gabeak2/KASM_ACTUATOR_PCB_REV2/README.md

A PCBA to drive voice coil actuators at Keck and University of Hawaii at Hilo.  Work done as part of my MS ECE Thesis at Johns Hopkins.  Please enjoy this beautiful glamor shot of my boards !
