gabeak2/KASM_ACTUATOR_PCB_REV2/kasm_pcb_rev2.step

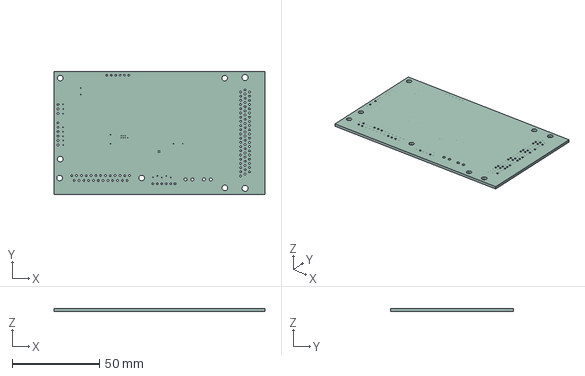
[picture p1: CAD file, 2024-11-26]
kasm_pcb_rev2.step
121.0 x 70.6 x 1.60 mm
