gabeak2/KASM_ACTUATOR_PCB_REV2/parts_libraries/LIB_09564527612/09564527612/3D/09564527612.stp

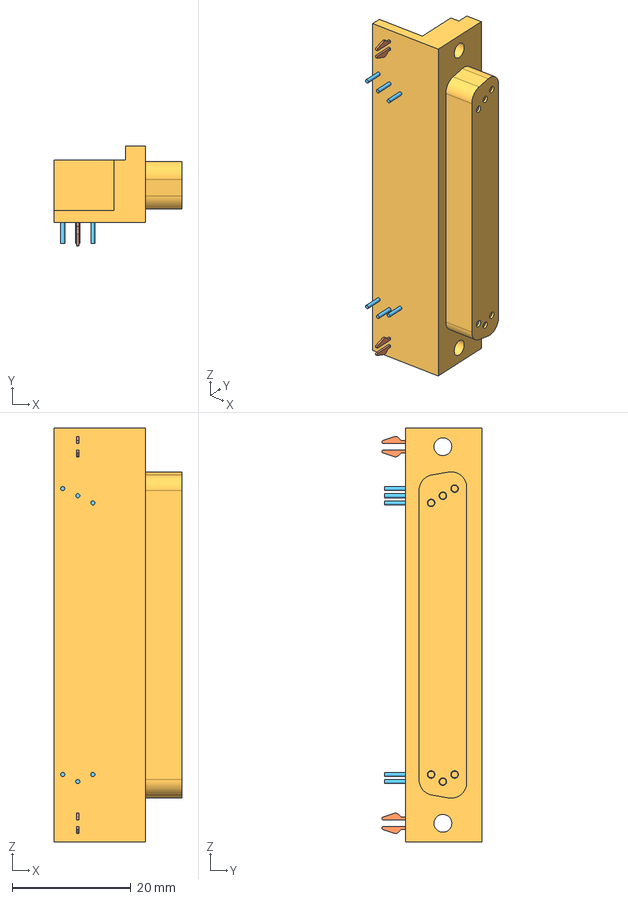
[picture p2: CAD file, 2024-10-26]
parts_libraries/LIB_09564527612/09564527612/3D/09564527612.stp
21.5 x 16.9 x 69.8 mm
