gabeak2/KASM_ACTUATOR_PCB_REV2/(list of files, cad)

Other CAD files:
parts_libraries/LIB_09564527612/09564527612/Allegro/09564527612.psm
parts_libraries/LIB_09564527612/09564527612/DEHDL/09564527612/chips/chips.prt
