gabeak2/KASM_ACTUATOR_PCB_REV2/(list of files, drawings)

Other design files:
parts_libraries/LIB_09564527612/09564527612/Altium/09564527612.PcbLib
parts_libraries/LIB_09564527612/09564527612/Altium/09564527612.SchLib
