gabeak2/KASM_ACTUATOR_PCB_REV2/kasm_pcb_rev2.kicad_pcb

## KiCad design kasm_pcb_rev2.kicad_pcb (2024-11-26)

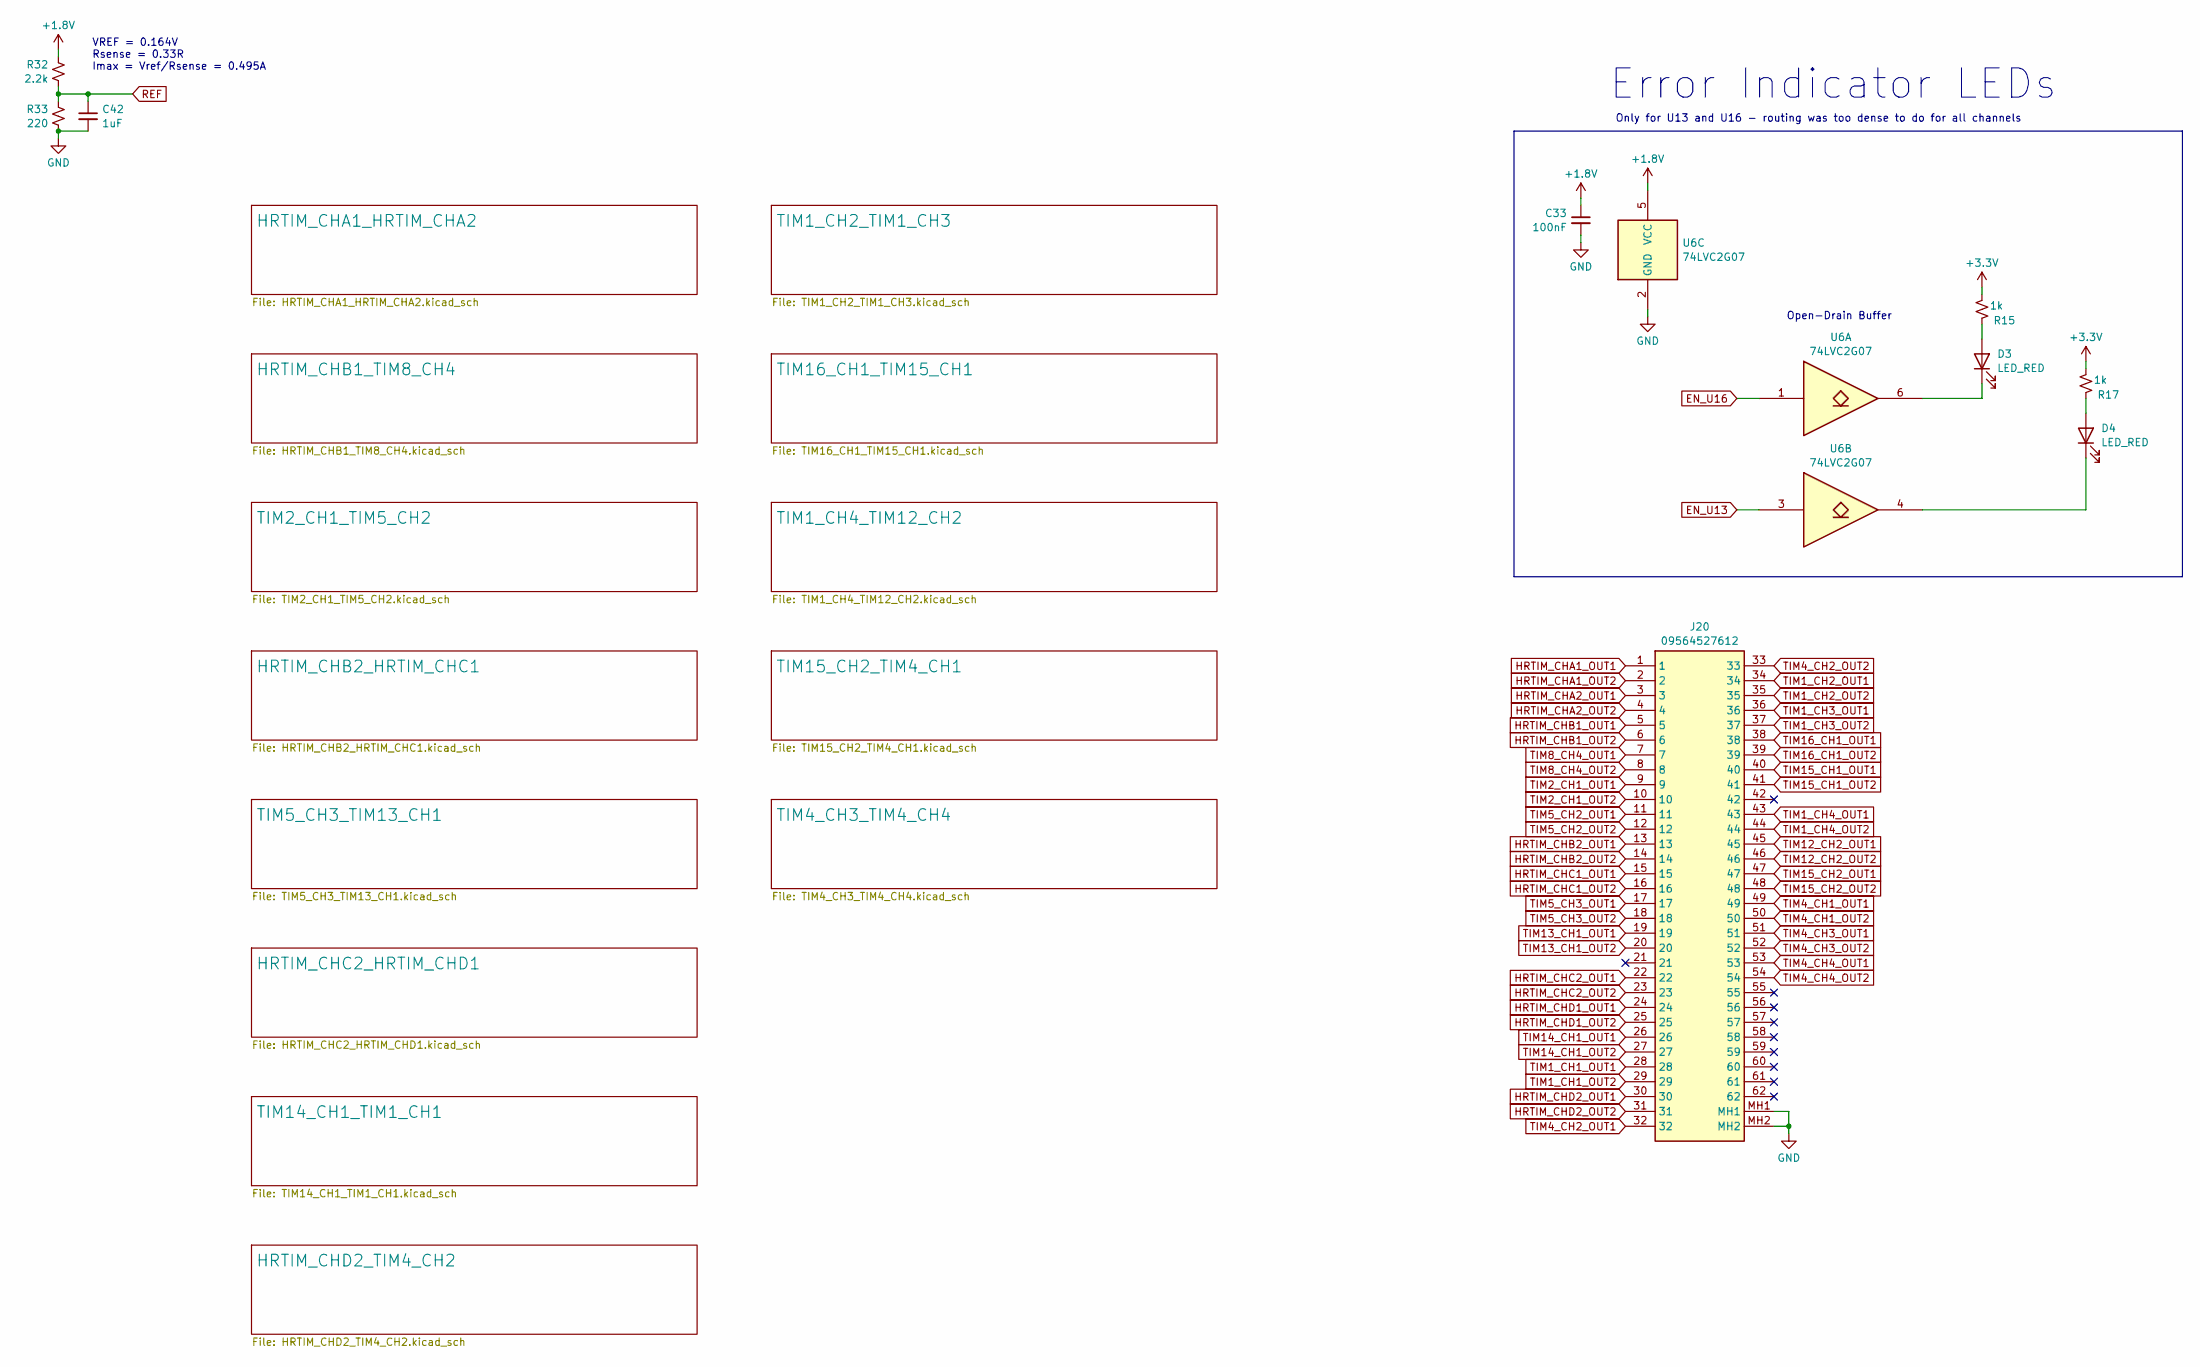
[picture p3: schematic actuators.kicad_sch, KASM Actuator PCBA Rev2]

Parts:
C33: 100nF; C_0402_1005Metric; LCSC C1525
C42: 1uF; C_0402_1005Metric; LCSC C52923
D3, D4: LED_RED; LED_0603_1608Metric; LCSC C2286
J20: 09564527612; Manufacturer_Part_Number 09564527612; Mouser Part Number 617-09-56-452-7612
R15, R17: 1k; R_0402_1005Metric; LCSC C11702
R32: 2.2k; R_0402_1005Metric; LCSC C25879
R33: 220; R_0402_1005Metric; LCSC C25091
U6: 74LVC2G07; SOT-23-6; LCSC C37708

Connections:
+1.8V: C33.1, R32.1, U6.5 (VCC); also elsewhere on the board
+3.3V: R15.1, R17.1; also elsewhere on the board
EN_U13: U6.3; also elsewhere on the board
EN_U16: U6.1; also elsewhere on the board
GND: C33.2, C42.2, J20.MH1, J20.MH2, R33.2, U6.2 (GND); also elsewhere on the board
HRTIM_CHA1_OUT1: J20.1; also elsewhere on the board
HRTIM_CHA1_OUT2: J20.2; also elsewhere on the board
HRTIM_CHA2_OUT1: J20.3; also elsewhere on the board
HRTIM_CHA2_OUT2: J20.4; also elsewhere on the board
HRTIM_CHB1_OUT1: J20.5; also elsewhere on the board
HRTIM_CHB1_OUT2: J20.6; also elsewhere on the board
HRTIM_CHB2_OUT1: J20.13; also elsewhere on the board
HRTIM_CHB2_OUT2: J20.14; also elsewhere on the board
HRTIM_CHC1_OUT1: J20.15; also elsewhere on the board
HRTIM_CHC1_OUT2: J20.16; also elsewhere on the board
HRTIM_CHC2_OUT1: J20.22; also elsewhere on the board
HRTIM_CHC2_OUT2: J20.23; also elsewhere on the board
HRTIM_CHD1_OUT1: J20.24; also elsewhere on the board
HRTIM_CHD1_OUT2: J20.25; also elsewhere on the board
HRTIM_CHD2_OUT1: J20.30; also elsewhere on the board
HRTIM_CHD2_OUT2: J20.31; also elsewhere on the board
unnamed: D3.2 (A), R15.2
unnamed: D3.1 (K), U6.6
unnamed: D4.2 (A), R17.2
unnamed: D4.1 (K), U6.4
REF: C42.1, R32.2, R33.1; also elsewhere on the board
TIM1_CH1_OUT1: J20.28; also elsewhere on the board
TIM1_CH1_OUT2: J20.29; also elsewhere on the board
TIM1_CH2_OUT1: J20.34; also elsewhere on the board
TIM1_CH2_OUT2: J20.35; also elsewhere on the board
TIM1_CH3_OUT1: J20.36; also elsewhere on the board
TIM1_CH3_OUT2: J20.37; also elsewhere on the board
TIM1_CH4_OUT1: J20.43; also elsewhere on the board
TIM1_CH4_OUT2: J20.44; also elsewhere on the board
TIM2_CH1_OUT1: J20.9; also elsewhere on the board
TIM2_CH1_OUT2: J20.10; also elsewhere on the board
TIM4_CH1_OUT1: J20.49; also elsewhere on the board
TIM4_CH1_OUT2: J20.50; also elsewhere on the board
TIM4_CH2_OUT1: J20.32; also elsewhere on the board
TIM4_CH2_OUT2: J20.33; also elsewhere on the board
TIM4_CH3_OUT1: J20.51; also elsewhere on the board
TIM4_CH3_OUT2: J20.52; also elsewhere on the board
TIM4_CH4_OUT1: J20.53; also elsewhere on the board
TIM4_CH4_OUT2: J20.54; also elsewhere on the board
TIM5_CH2_OUT1: J20.11; also elsewhere on the board
TIM5_CH2_OUT2: J20.12; also elsewhere on the board
TIM5_CH3_OUT1: J20.17; also elsewhere on the board
TIM5_CH3_OUT2: J20.18; also elsewhere on the board
TIM8_CH4_OUT1: J20.7; also elsewhere on the board
TIM8_CH4_OUT2: J20.8; also elsewhere on the board
TIM12_CH2_OUT1: J20.45; also elsewhere on the board
TIM12_CH2_OUT2: J20.46; also elsewhere on the board
TIM13_CH1_OUT1: J20.19; also elsewhere on the board
TIM13_CH1_OUT2: J20.20; also elsewhere on the board
TIM14_CH1_OUT1: J20.26; also elsewhere on the board
TIM14_CH1_OUT2: J20.27; also elsewhere on the board
TIM15_CH1_OUT1: J20.40; also elsewhere on the board
TIM15_CH1_OUT2: J20.41; also elsewhere on the board
TIM15_CH2_OUT1: J20.47; also elsewhere on the board
TIM15_CH2_OUT2: J20.48; also elsewhere on the board
TIM16_CH1_OUT1: J20.38; also elsewhere on the board
TIM16_CH1_OUT2: J20.39; also elsewhere on the board

Notes on the sheet:
Only for U13 and U16 - routing was too dense to do for all channels
Error Indicator LEDs
Open-Drain Buffer
VREF = 0.164V Rsense = 0.33R Imax = Vref/Rsense = 0.495A

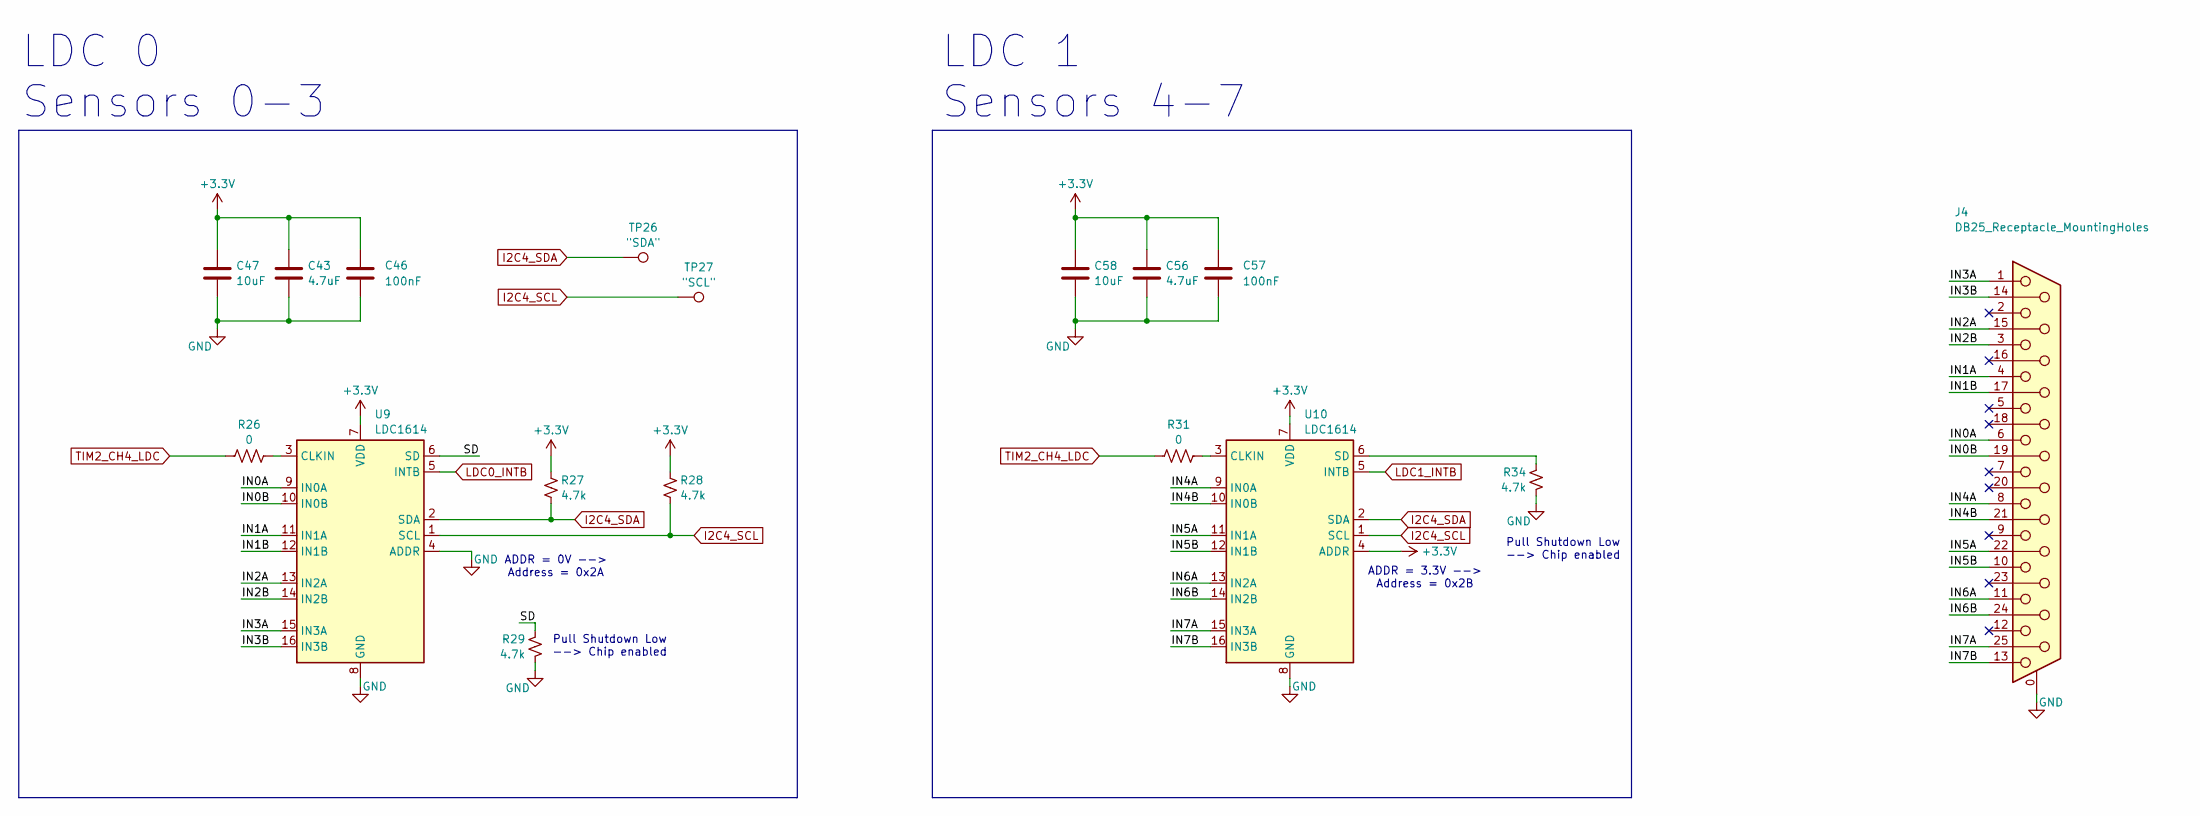
[picture p4: schematic eddy_current_sensors.kicad_sch, KASM Actuator PCBA Rev2]

Parts:
C43, C56: 4.7uF; C_0402_1005Metric; LCSC C23733
C46, C57: 100nF; C_0402_1005Metric; LCSC C307331
C47, C58: 10uF; C_0805_2012Metric; LCSC C440198
J4: DB25_Receptacle_MountingHoles; TE_5747846-4
R26, R31: 0; R_0402_1005Metric; LCSC C17168
R27, R28, R29, R34: 4.7k; R_0402_1005Metric; LCSC C25900
TP26: "SDA"; TestPoint_THTPad_D1.0mm_Drill0.5mm
TP27: "SCL"; TestPoint_THTPad_D1.0mm_Drill0.5mm
U9, U10: LDC1614; WQFN-16-1EP_4x4mm_P0.5mm_EP2.6x2.6mm; LCSC C968448

Connections:
+3.3V: C43.1, C46.1, C47.1, C56.1, C57.1, C58.1, R27.1, R28.1, U9.7 (VDD), U10.4 (ADDR), U10.7 (VDD); also elsewhere on the board
/Eddy Current Sensors/IN0A: J4.6, U9.9 (IN0A)
/Eddy Current Sensors/IN0B: J4.19, U9.10 (IN0B)
/Eddy Current Sensors/IN1A: J4.4, U9.11 (IN1A)
/Eddy Current Sensors/IN1B: J4.17, U9.12 (IN1B)
/Eddy Current Sensors/IN2A: J4.15, U9.13 (IN2A)
/Eddy Current Sensors/IN2B: J4.3, U9.14 (IN2B)
/Eddy Current Sensors/IN3A: J4.1, U9.15 (IN3A)
/Eddy Current Sensors/IN3B: J4.14, U9.16 (IN3B)
/Eddy Current Sensors/IN4A: J4.8, U10.9 (IN0A)
/Eddy Current Sensors/IN4B: J4.21, U10.10 (IN0B)
/Eddy Current Sensors/IN5A: J4.22, U10.11 (IN1A)
/Eddy Current Sensors/IN5B: J4.10, U10.12 (IN1B)
/Eddy Current Sensors/IN6A: J4.11, U10.13 (IN2A)
/Eddy Current Sensors/IN6B: J4.24, U10.14 (IN2B)
/Eddy Current Sensors/IN7A: J4.25, U10.15 (IN3A)
/Eddy Current Sensors/IN7B: J4.13, U10.16 (IN3B)
/Eddy Current Sensors/SD: R29.1, U9.6 (SD)
GND: C43.2, C46.2, C47.2, C56.2, C57.2, C58.2, J4.0 (PAD), R29.2, R34.2, U9.4 (ADDR), U9.8 (GND), U9.17 (GND), U10.8 (GND), U10.17 (GND); also elsewhere on the board
I2C4_SCL: R28.2, TP27.1, U9.1 (SCL), U10.1 (SCL); also elsewhere on the board
I2C4_SDA: R27.2, TP26.1, U9.2 (SDA), U10.2 (SDA); also elsewhere on the board
LDC0_INTB: U9.5 (INTB); also elsewhere on the board
LDC1_INTB: U10.5 (INTB); also elsewhere on the board
unnamed: R26.1, U9.3 (CLKIN)
unnamed: R31.1, U10.3 (CLKIN)
unnamed: R34.1, U10.6 (SD)
TIM2_CH4_LDC: R26.2, R31.2; also elsewhere on the board

Notes on the sheet:
Pull Shutdown Low --> Chip enabled
LDC 0 Sensors 0-3
LDC 1 Sensors 4-7
ADDR = 3.3V --> Address = 0x2B
ADDR = 0V --> Address = 0x2A

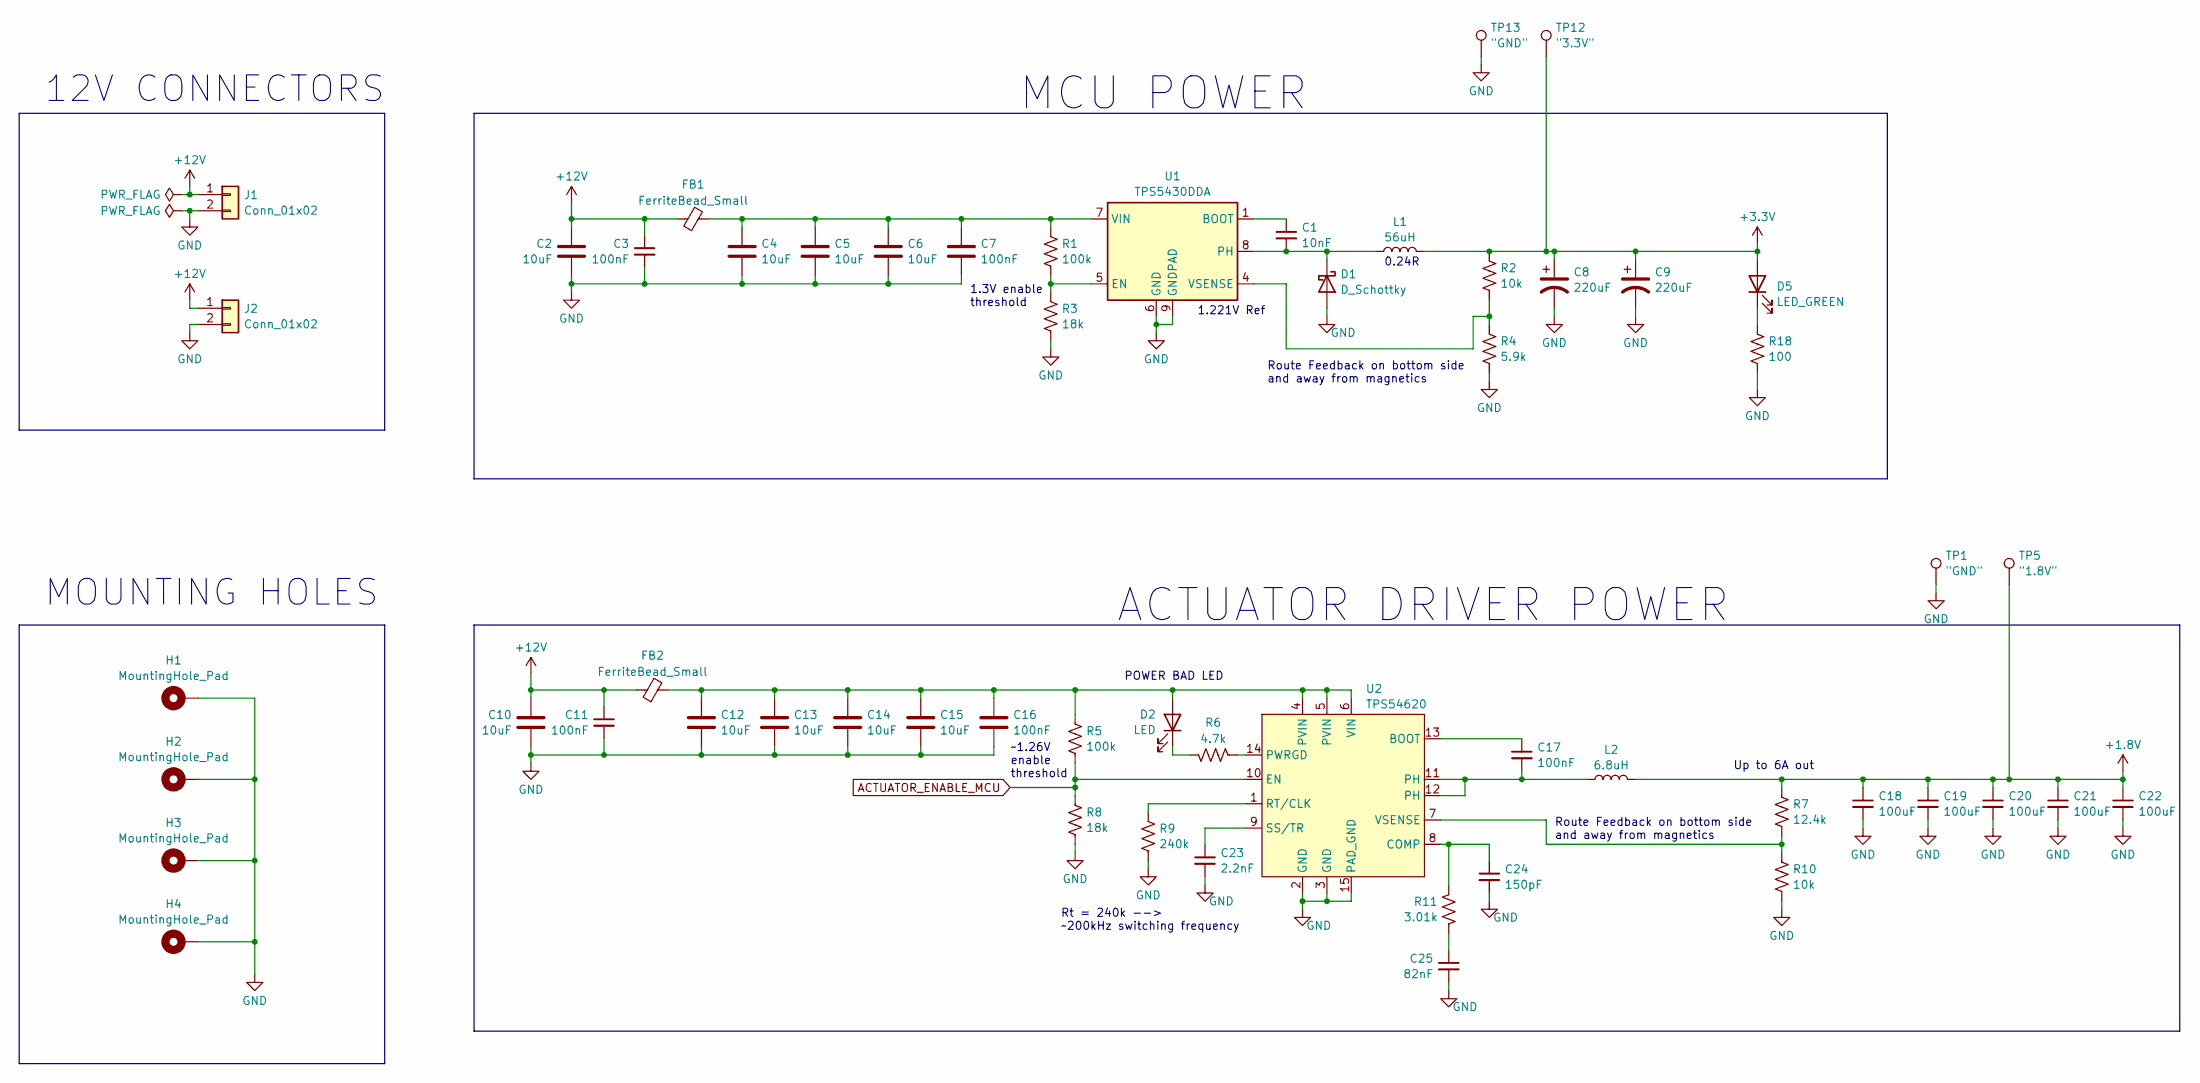
[picture p5: schematic power.kicad_sch, KASM Actuator PCBA Rev2]

Parts:
C1: 10nF; C_0402_1005Metric; LCSC C60133
C2, C4, C5, C6, C10, C12, C13, C14, C15: 10uF; C_1206_3216Metric; LCSC C454102
C3, C7, C11, C16, C17: 100nF; C_0402_1005Metric; LCSC C1525
C8, C9: 220uF; CP_Elec_6.3x5.4; LCSC C59953
C18, C19, C20, C21, C22: 100uF; C_1206_3216Metric; LCSC C15008
C23: 2.2nF; C_0402_1005Metric; LCSC C1531
C24: 150pF; C_0402_1005Metric; LCSC C106998
C25: 82nF; C_0402_1005Metric; LCSC C524617
D1: D_Schottky; D_SOD-323; LCSC C191023
D2: LED; LED_0603_1608Metric; LCSC C2286
D5: LED_GREEN; LED_0603_1608Metric; LCSC C965804
FB1, FB2: FerriteBead_Small; L_0805_2012Metric; LCSC C1017
H1, H2, H3, H4: MountingHole_Pad; MountingHole_3.2mm_M3_DIN965_Pad
J1, J2: Conn_01x02; Molex_KK-396_A-41792-0002_1x02_P3.96mm_Horizontal
L1: 56uH; L_Changjiang_FNR5020S; LCSC C167944
L2: 6.8uH; L_Chilisin_BMRF00101040; LCSC C167231
R1, R5: 100k; R_0402_1005Metric; LCSC C25741
R2, R10: 10k; R_0402_1005Metric; LCSC C25744
R3, R8: 18k; R_0402_1005Metric; LCSC C138044
R4: 5.9k; R_0402_1005Metric; LCSC C270591
R6: 4.7k; R_0402_1005Metric; LCSC C25900
R7: 12.4k; R_0402_1005Metric; LCSC C11692
R9: 240k; R_0402_1005Metric; LCSC C138030
R11: 3.01k; R_0402_1005Metric; LCSC C137994
R18: 100; R_0402_1005Metric; LCSC C106232
TP1, TP13: "GND"; TestPoint_THTPad_1.0x1.0mm_Drill0.5mm
TP5: "1.8V"; TestPoint_THTPad_1.0x1.0mm_Drill0.5mm
TP12: "3.3V"; TestPoint_THTPad_1.0x1.0mm_Drill0.5mm
U1: TPS5430DDA; TI_SO-PowerPAD-8_ThermalVias; LCSC C9864
U2: TPS54620; Texas_S-PVQFN-N14_ThermalVias; LCSC C29438

Connections:
+1.8V: C18.1, C19.1, C20.1, C21.1, C22.1, L2.2, R7.1, TP5.1; also elsewhere on the board
+3.3V: C8.1, C9.1, D5.2 (A), L1.2, R2.1, TP12.1; also elsewhere on the board
+12V: C2.1, C3.1, C10.1, C11.1, FB1.1, FB2.1, J1.1, J2.1
ACTUATOR_ENABLE_MCU: R5.2, R8.1, U2.10 (EN); also elsewhere on the board
GND: C2.2, C3.2, C4.2, C5.2, C6.2, C7.2, C8.2, C9.2, C10.2, C11.2, C12.2, C13.2, C14.2, C15.2, C16.2, C18.2, C19.2, C20.2, C21.2, C22.2, C23.2, C24.2, C25.2, D1.2 (A), H1.1, H2.1, H3.1, H4.1, J1.2, J2.2, R3.2, R4.2, R8.2, R9.2, R10.2, R18.2, TP1.1, TP13.1, U1.6 (GND), U1.9 (GNDPAD), U2.2 (GND), U2.3 (GND), U2.15 (PAD_GND); also elsewhere on the board
unnamed: C17.2, L2.1, U2.11 (PH), U2.12 (PH)
unnamed: C25.1, R11.2
unnamed: C1.2, D1.1 (K), L1.1, U1.8 (PH)
unnamed: C12.1, C13.1, C14.1, C15.1, C16.1, D2.2 (A), FB2.2, R5.1, U2.4 (PVIN), U2.5 (PVIN), U2.6 (VIN)
unnamed: D2.1 (K), R6.2
unnamed: D5.1 (K), R18.1
unnamed: C1.1, U1.1 (BOOT)
unnamed: R1.2, R3.1, U1.5 (EN)
unnamed: C4.1, C5.1, C6.1, C7.1, FB1.2, R1.1, U1.7 (VIN)
unnamed: R2.2, R4.1, U1.4 (VSENSE)
unnamed: C17.1, U2.13 (BOOT)
unnamed: C24.1, R11.1, U2.8 (COMP)
unnamed: R6.1, U2.14 (PWRGD)
unnamed: R9.1, U2.1 (RT/CLK)
unnamed: C23.1, U2.9 (SS/TR)
unnamed: R7.2, R10.1, U2.7 (VSENSE)

Notes on the sheet:
Up to 6A out
1.221V Ref
Rt = 240k --> ~200kHz switching frequency
1.3V enable threshold
Route Feedback on bottom side and away from magnetics
ACTUATOR DRIVER POWER
~1.26V enable threshold
0.24R
POWER BAD LED
12V CONNECTORS
MCU POWER
MOUNTING HOLES

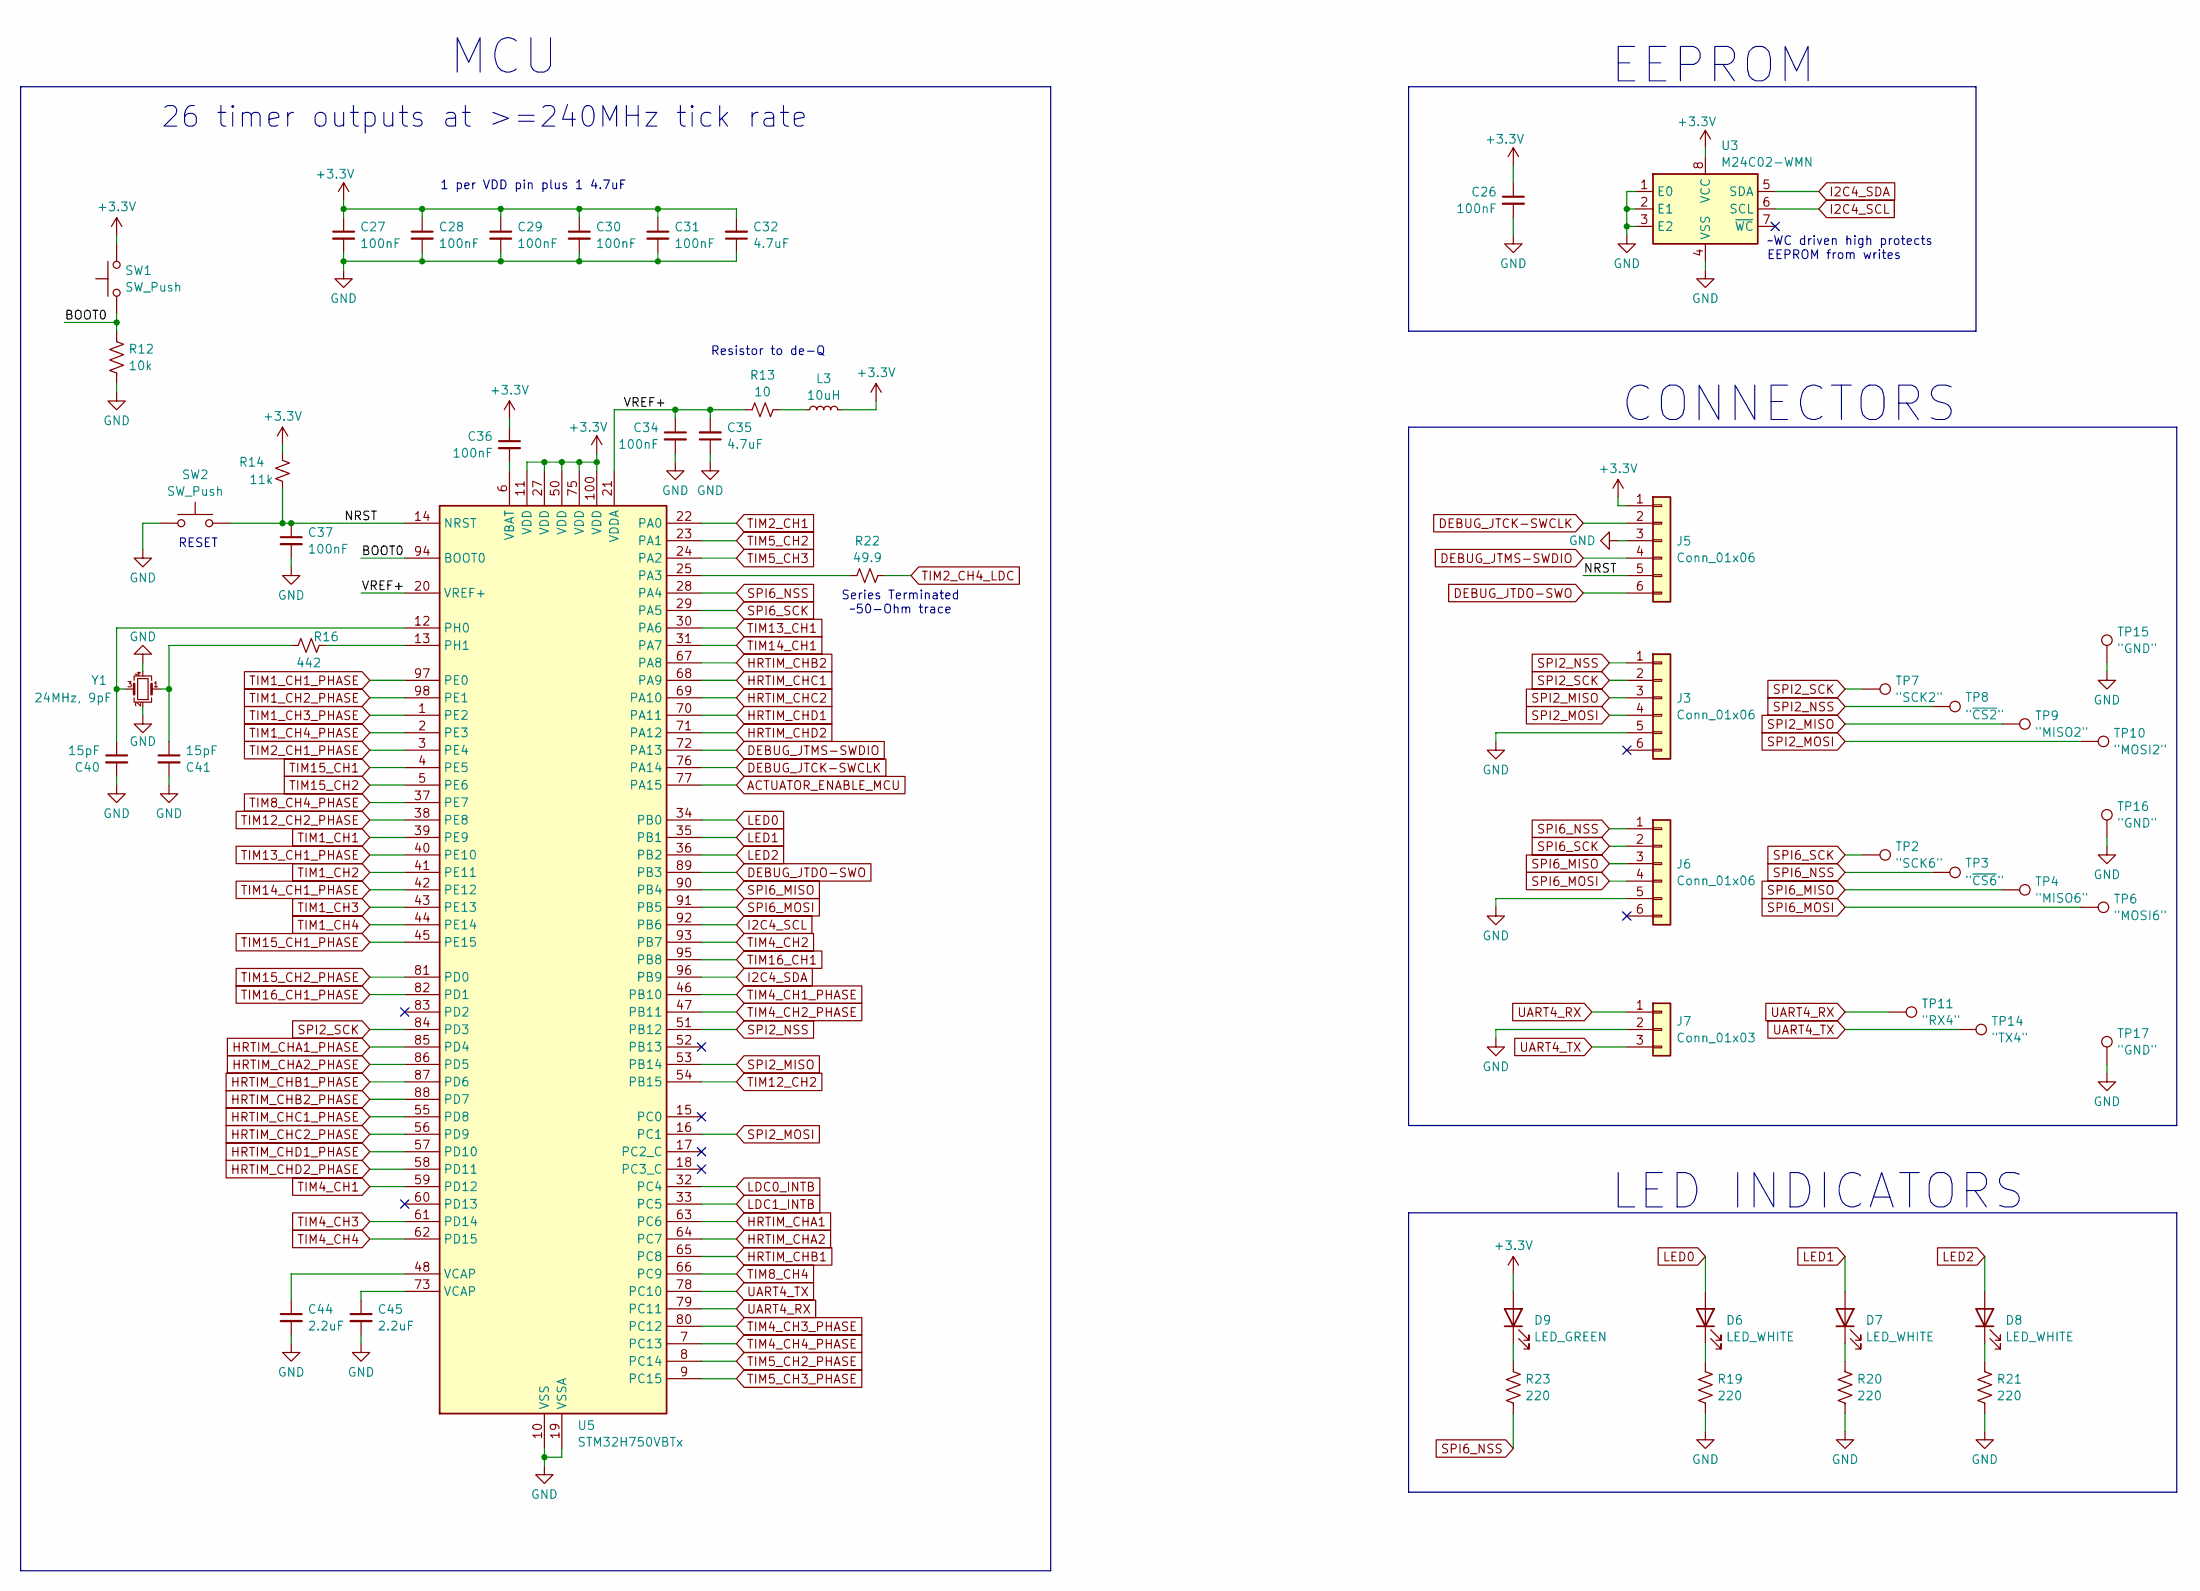
[picture p6: schematic mcu.kicad_sch, KASM Actuator PCBA Rev2]

Parts:
C26, C27, C28, C29, C30, C31, C34, C36, C37: 100nF; C_0402_1005Metric; LCSC C1525
C32, C35: 4.7uF; C_0402_1005Metric; LCSC C23733
C40, C41: 15pF; C_0402_1005Metric; LCSC C1548
C44, C45: 2.2uF; C_0402_1005Metric; LCSC C12530
D6, D7, D8: LED_WHITE; LED_0402_1005Metric; LCSC C20613596
D9: LED_GREEN; LED_0603_1608Metric; LCSC C965804
J3, J5: Conn_01x06; PinHeader_1x06_P2.54mm_Vertical
J6: Conn_01x06; CONN_A-7478-06A_MOL
J7: Conn_01x03; PinHeader_1x03_P2.54mm_Vertical
L3: 10uH; L_0603_1608Metric; LCSC C51942
R12: 10k; R_0402_1005Metric; LCSC C25744
R13: 10; R_0402_1005Metric; LCSC C409845
R14: 11k; R_0402_1005Metric; LCSC C25749
R16: 442; R_0402_1005Metric; LCSC C126137
R19, R20, R21, R23: 220; R_0402_1005Metric; LCSC C25091
R22: 49.9; R_0402_1005Metric; LCSC C144754
SW1, SW2: SW_Push; SW_Push_1P1T_XKB_TS-1187A; LCSC C318884
TP2: "SCK6"; TestPoint_THTPad_1.0x1.0mm_Drill0.5mm
TP3: "~{CS6}"; TestPoint_THTPad_1.0x1.0mm_Drill0.5mm
TP4: "MISO6"; TestPoint_THTPad_1.0x1.0mm_Drill0.5mm
TP6: "MOSI6"; TestPoint_THTPad_1.0x1.0mm_Drill0.5mm
TP7: "SCK2"; TestPoint_THTPad_1.0x1.0mm_Drill0.5mm
TP8: "~{CS2}"; TestPoint_THTPad_1.0x1.0mm_Drill0.5mm
TP9: "MISO2"; TestPoint_THTPad_1.0x1.0mm_Drill0.5mm
TP10: "MOSI2"; TestPoint_THTPad_1.0x1.0mm_Drill0.5mm
TP11: "RX4"; TestPoint_THTPad_1.0x1.0mm_Drill0.5mm
TP14: "TX4"; TestPoint_THTPad_1.0x1.0mm_Drill0.5mm
TP15, TP16, TP17: "GND"; TestPoint_THTPad_1.0x1.0mm_Drill0.5mm
U3: M24C02-WMN; SOIC-8_3.9x4.9mm_P1.27mm; LCSC C7562
U5: STM32H750VBTx; LQFP-100_14x14mm_P0.5mm; LCSC C404010
Y1: 24MHz, 9pF; Crystal_SMD_SeikoEpson_FA128-4Pin_2.0x1.6mm; LCSC C2929399

Connections:
+3.3V: C26.1, C27.1, C28.1, C29.1, C30.1, C31.1, C32.2, C36.1, D9.2 (A), J5.1, L3.2, R14.1, SW1.2, U3.8 (VCC), U5.11 (VDD), U5.27 (VDD), U5.50 (VDD), U5.75 (VDD), U5.100 (VDD); also elsewhere on the board
/MCU/BOOT0: R12.1, SW1.1, U5.94 (BOOT0)
/MCU/NRST: C37.1, J5.5, R14.2, SW2.2, U5.14 (NRST)
/MCU/VREF+: C34.1, C35.2, R13.1, U5.20 (VREF+), U5.21 (VDDA)
ACTUATOR_ENABLE_MCU: U5.77 (PA15); also elsewhere on the board
DEBUG_JTCK-SWCLK: J5.2, U5.76 (PA14)
DEBUG_JTDO-SWO: J5.6, U5.89 (PB3)
DEBUG_JTMS-SWDIO: J5.4, U5.72 (PA13)
GND: C26.2, C27.2, C28.2, C29.2, C30.2, C31.2, C32.1, C34.2, C35.1, C37.2, C40.2, C41.2, C44.2, C45.2, J3.5, J5.3, J6.5, J7.2, R12.2, R19.2, R20.2, R21.2, SW2.1, TP15.1, TP16.1, TP17.1, U3.1 (E0), U3.2 (E1), U3.3 (E2), U3.4 (VSS), U5.10 (VSS), U5.19 (VSSA), U5.26 (VSS), U5.49 (VSS), U5.74 (VSS), U5.99 (VSS), Y1.2, Y1.4; also elsewhere on the board
HRTIM_CHA1: U5.63 (PC6); also elsewhere on the board
HRTIM_CHA1_PHASE: U5.85 (PD4); also elsewhere on the board
HRTIM_CHA2: U5.64 (PC7); also elsewhere on the board
HRTIM_CHA2_PHASE: U5.86 (PD5); also elsewhere on the board
HRTIM_CHB1: U5.65 (PC8); also elsewhere on the board
HRTIM_CHB1_PHASE: U5.87 (PD6); also elsewhere on the board
HRTIM_CHB2: U5.67 (PA8); also elsewhere on the board
HRTIM_CHB2_PHASE: U5.88 (PD7); also elsewhere on the board
HRTIM_CHC1: U5.68 (PA9); also elsewhere on the board
HRTIM_CHC1_PHASE: U5.55 (PD8); also elsewhere on the board
HRTIM_CHC2: U5.69 (PA10); also elsewhere on the board
HRTIM_CHC2_PHASE: U5.56 (PD9); also elsewhere on the board
HRTIM_CHD1: U5.70 (PA11); also elsewhere on the board
HRTIM_CHD1_PHASE: U5.57 (PD10); also elsewhere on the board
HRTIM_CHD2: U5.71 (PA12); also elsewhere on the board
HRTIM_CHD2_PHASE: U5.58 (PD11); also elsewhere on the board
I2C4_SCL: U3.6 (SCL), U5.92 (PB6); also elsewhere on the board
I2C4_SDA: U3.5 (SDA), U5.96 (PB9); also elsewhere on the board
LDC0_INTB: U5.32 (PC4); also elsewhere on the board
LDC1_INTB: U5.33 (PC5); also elsewhere on the board
LED0: D6.2 (A), U5.34 (PB0)
LED1: D7.2 (A), U5.35 (PB1)
LED2: D8.2 (A), U5.36 (PB2)
unnamed: C41.1, R16.1, Y1.1
unnamed: C44.1, U5.48 (VCAP)
unnamed: C45.1, U5.73 (VCAP)
unnamed: D6.1 (K), R19.1
unnamed: D7.1 (K), R20.1
unnamed: D8.1 (K), R21.1
unnamed: D9.1 (K), R23.1
unnamed: L3.1, R13.2
unnamed: R22.1, U5.25 (PA3)
unnamed: C40.1, U5.12 (PH0), Y1.3
unnamed: R16.2, U5.13 (PH1)
unnamed: C36.2, U5.6 (VBAT)
SPI2_MISO: J3.3, TP9.1, U5.53 (PB14)
SPI2_MOSI: J3.4, TP10.1, U5.16 (PC1)
SPI2_NSS: J3.1, TP8.1, U5.51 (PB12)
SPI2_SCK: J3.2, TP7.1, U5.84 (PD3)
SPI6_MISO: J6.3, TP4.1, U5.90 (PB4)
SPI6_MOSI: J6.4, TP6.1, U5.91 (PB5)
SPI6_NSS: J6.1, R23.2, TP3.1, U5.28 (PA4)
SPI6_SCK: J6.2, TP2.1, U5.29 (PA5)
TIM1_CH1: U5.39 (PE9); also elsewhere on the board
TIM1_CH1_PHASE: U5.97 (PE0); also elsewhere on the board
TIM1_CH2: U5.41 (PE11); also elsewhere on the board
TIM1_CH2_PHASE: U5.98 (PE1); also elsewhere on the board
TIM1_CH3: U5.43 (PE13); also elsewhere on the board
TIM1_CH3_PHASE: U5.1 (PE2); also elsewhere on the board
TIM1_CH4: U5.44 (PE14); also elsewhere on the board
TIM1_CH4_PHASE: U5.2 (PE3); also elsewhere on the board
TIM2_CH1: U5.22 (PA0); also elsewhere on the board
TIM2_CH1_PHASE: U5.3 (PE4); also elsewhere on the board
TIM2_CH4_LDC: R22.2; also elsewhere on the board
TIM4_CH1: U5.59 (PD12); also elsewhere on the board
TIM4_CH1_PHASE: U5.46 (PB10); also elsewhere on the board
TIM4_CH2: U5.93 (PB7); also elsewhere on the board
TIM4_CH2_PHASE: U5.47 (PB11); also elsewhere on the board
TIM4_CH3: U5.61 (PD14); also elsewhere on the board
TIM4_CH3_PHASE: U5.80 (PC12); also elsewhere on the board
TIM4_CH4: U5.62 (PD15); also elsewhere on the board
TIM4_CH4_PHASE: U5.7 (PC13); also elsewhere on the board
TIM5_CH2: U5.23 (PA1); also elsewhere on the board
TIM5_CH2_PHASE: U5.8 (PC14); also elsewhere on the board
TIM5_CH3: U5.24 (PA2); also elsewhere on the board
TIM5_CH3_PHASE: U5.9 (PC15); also elsewhere on the board
TIM8_CH4: U5.66 (PC9); also elsewhere on the board
TIM8_CH4_PHASE: U5.37 (PE7); also elsewhere on the board
TIM12_CH2: U5.54 (PB15); also elsewhere on the board
TIM12_CH2_PHASE: U5.38 (PE8); also elsewhere on the board
TIM13_CH1: U5.30 (PA6); also elsewhere on the board
TIM13_CH1_PHASE: U5.40 (PE10); also elsewhere on the board
TIM14_CH1: U5.31 (PA7); also elsewhere on the board
TIM14_CH1_PHASE: U5.42 (PE12); also elsewhere on the board
TIM15_CH1: U5.4 (PE5); also elsewhere on the board
TIM15_CH1_PHASE: U5.45 (PE15); also elsewhere on the board
TIM15_CH2: U5.5 (PE6); also elsewhere on the board
TIM15_CH2_PHASE: U5.81 (PD0); also elsewhere on the board
TIM16_CH1: U5.95 (PB8); also elsewhere on the board
TIM16_CH1_PHASE: U5.82 (PD1); also elsewhere on the board
UART4_RX: J7.1, TP11.1, U5.79 (PC11)
UART4_TX: J7.3, TP14.1, U5.78 (PC10)

Notes on the sheet:
~WC driven high protects EEPROM from writes
CONNECTORS
RESET
26 timer outputs at >=240MHz tick rate
Series Terminated ~50-Ohm trace
Resistor to de-Q
MCU
LED INDICATORS
EEPROM
1 per VDD pin plus 1 4.7uF

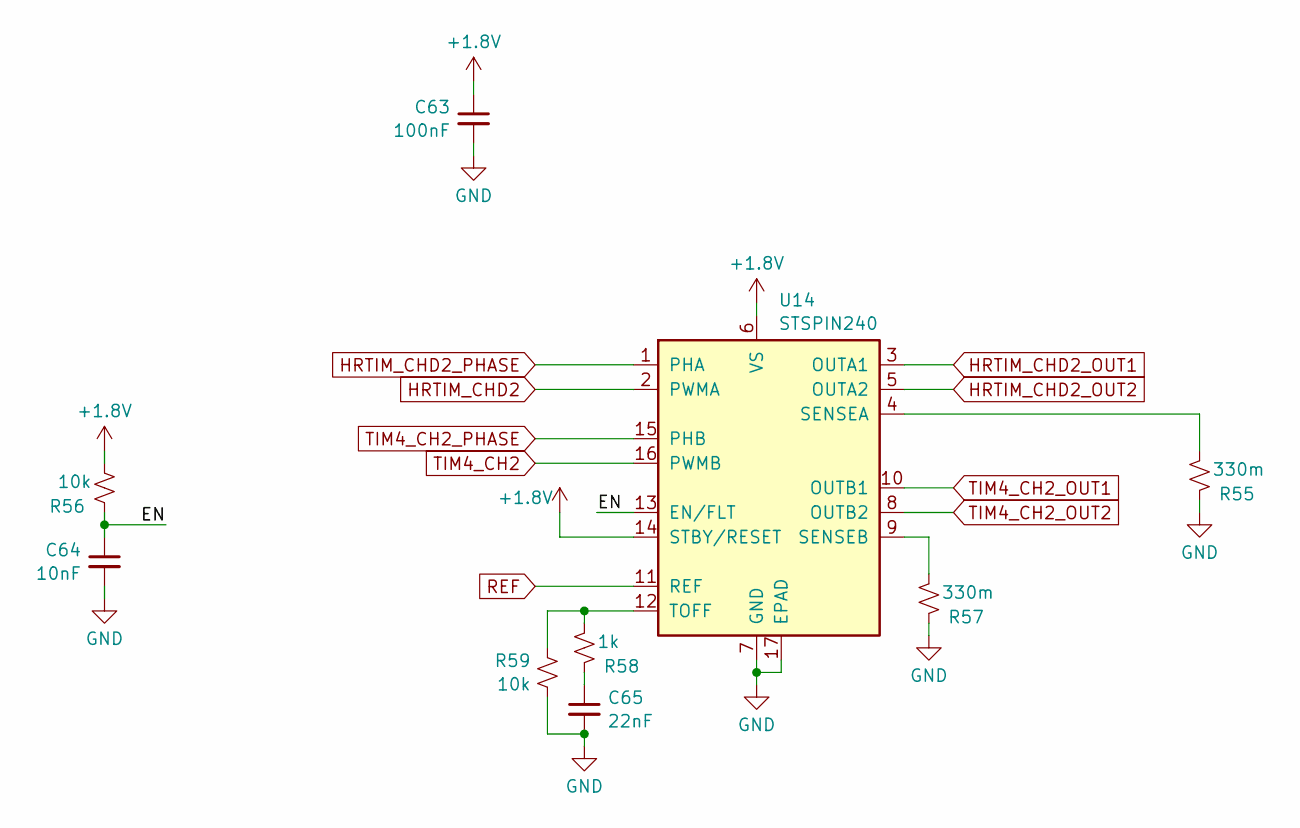
[picture p7: schematic HRTIM_CHD2_TIM4_CH2.kicad_sch]

Parts:
C63: 100nF; C_0402_1005Metric; LCSC C1525
C64: 10nF; C_0402_1005Metric; LCSC C15195
C65: 22nF; C_0402_1005Metric; LCSC C1532
R55, R57: 330m; R_0402_1005Metric; LCSC C332660
R56, R59: 10k; R_0402_1005Metric; LCSC C25744
R58: 1k; R_0402_1005Metric; LCSC C11702
U14: STSPIN240; VQFN-16-1EP_3x3mm_P0.5mm_EP1.8x1.8mm; LCSC C962258

Connections:
+1.8V: C63.1, R56.1, U14.6 (VS), U14.14 (STBY/RESET); also elsewhere on the board
/Actuators/HRTIM_CHD2_TIM4_CH2/EN: C64.1, R56.2, U14.13 (EN/FLT)
GND: C63.2, C64.2, C65.2, R55.2, R57.2, R59.2, U14.7 (GND), U14.17 (EPAD); also elsewhere on the board
HRTIM_CHD2: U14.2 (PWMA); also elsewhere on the board
HRTIM_CHD2_OUT1: U14.3 (OUTA1); also elsewhere on the board
HRTIM_CHD2_OUT2: U14.5 (OUTA2); also elsewhere on the board
HRTIM_CHD2_PHASE: U14.1 (PHA); also elsewhere on the board
unnamed: C65.1, R58.2
unnamed: R55.1, U14.4 (SENSEA)
unnamed: R57.1, U14.9 (SENSEB)
unnamed: R58.1, R59.1, U14.12 (TOFF)
REF: U14.11 (REF); also elsewhere on the board
TIM4_CH2: U14.16 (PWMB); also elsewhere on the board
TIM4_CH2_OUT1: U14.10 (OUTB1); also elsewhere on the board
TIM4_CH2_OUT2: U14.8 (OUTB2); also elsewhere on the board
TIM4_CH2_PHASE: U14.15 (PHB); also elsewhere on the board
