gabeak2/KASM_ACTUATOR_PCB_REV2/kasm_pcb_rev2.kicad_pcb

## KiCad design kasm_pcb_rev2.kicad_pcb (continued)

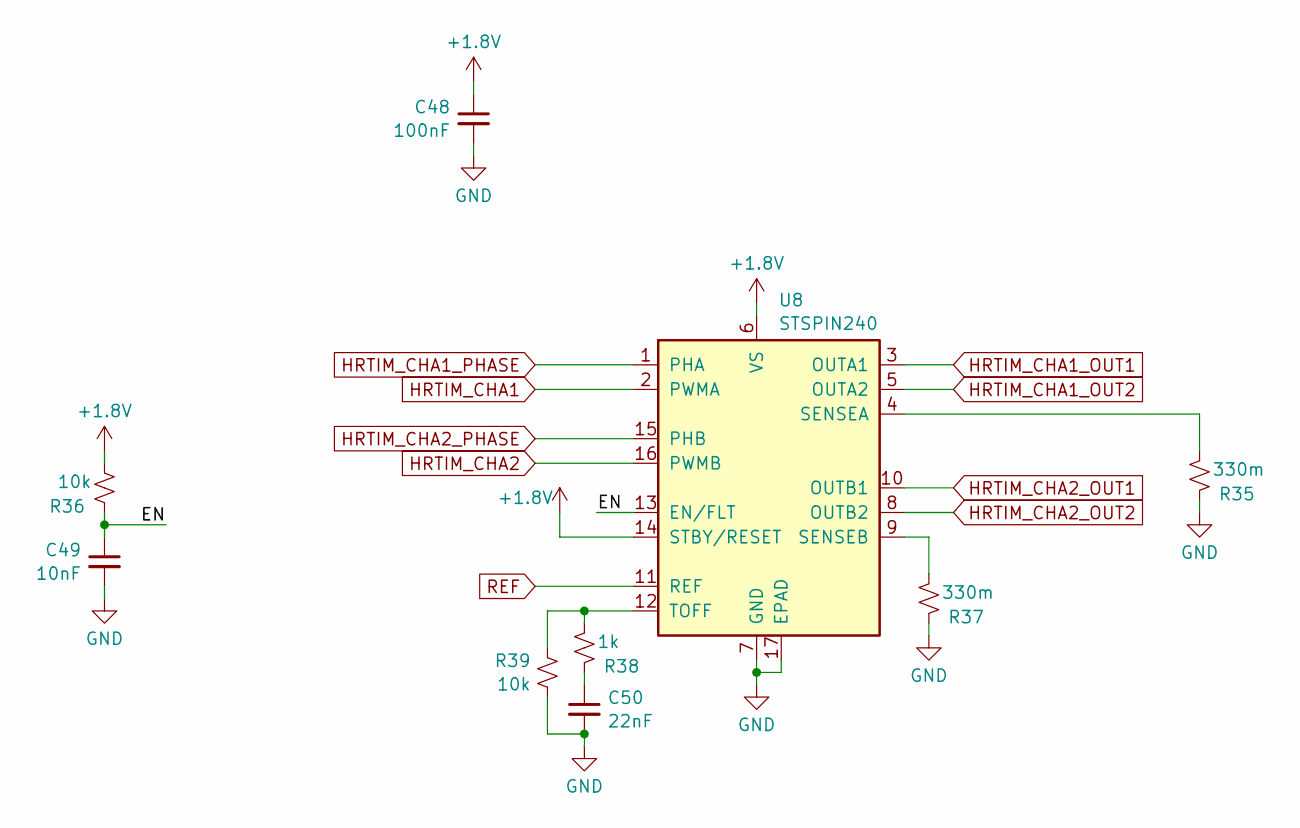
[picture p8: schematic HRTIM_CHA1_HRTIM_CHA2.kicad_sch]

Parts:
C48: 100nF; C_0402_1005Metric; LCSC C1525
C49: 10nF; C_0402_1005Metric; LCSC C15195
C50: 22nF; C_0402_1005Metric; LCSC C1532
R35, R37: 330m; R_0402_1005Metric; LCSC C332660
R36, R39: 10k; R_0402_1005Metric; LCSC C25744
R38: 1k; R_0402_1005Metric; LCSC C11702
U8: STSPIN240; VQFN-16-1EP_3x3mm_P0.5mm_EP1.8x1.8mm; LCSC C962258

Connections:
+1.8V: C48.1, R36.1, U8.6 (VS), U8.14 (STBY/RESET); also elsewhere on the board
/Actuators/HRTIM_CHA1_HRTIM_CHA2/EN: C49.1, R36.2, U8.13 (EN/FLT)
GND: C48.2, C49.2, C50.2, R35.2, R37.2, R39.2, U8.7 (GND), U8.17 (EPAD); also elsewhere on the board
HRTIM_CHA1: U8.2 (PWMA); also elsewhere on the board
HRTIM_CHA1_OUT1: U8.3 (OUTA1); also elsewhere on the board
HRTIM_CHA1_OUT2: U8.5 (OUTA2); also elsewhere on the board
HRTIM_CHA1_PHASE: U8.1 (PHA); also elsewhere on the board
HRTIM_CHA2: U8.16 (PWMB); also elsewhere on the board
HRTIM_CHA2_OUT1: U8.10 (OUTB1); also elsewhere on the board
HRTIM_CHA2_OUT2: U8.8 (OUTB2); also elsewhere on the board
HRTIM_CHA2_PHASE: U8.15 (PHB); also elsewhere on the board
unnamed: C50.1, R38.2
unnamed: R35.1, U8.4 (SENSEA)
unnamed: R37.1, U8.9 (SENSEB)
unnamed: R38.1, R39.1, U8.12 (TOFF)
REF: U8.11 (REF); also elsewhere on the board

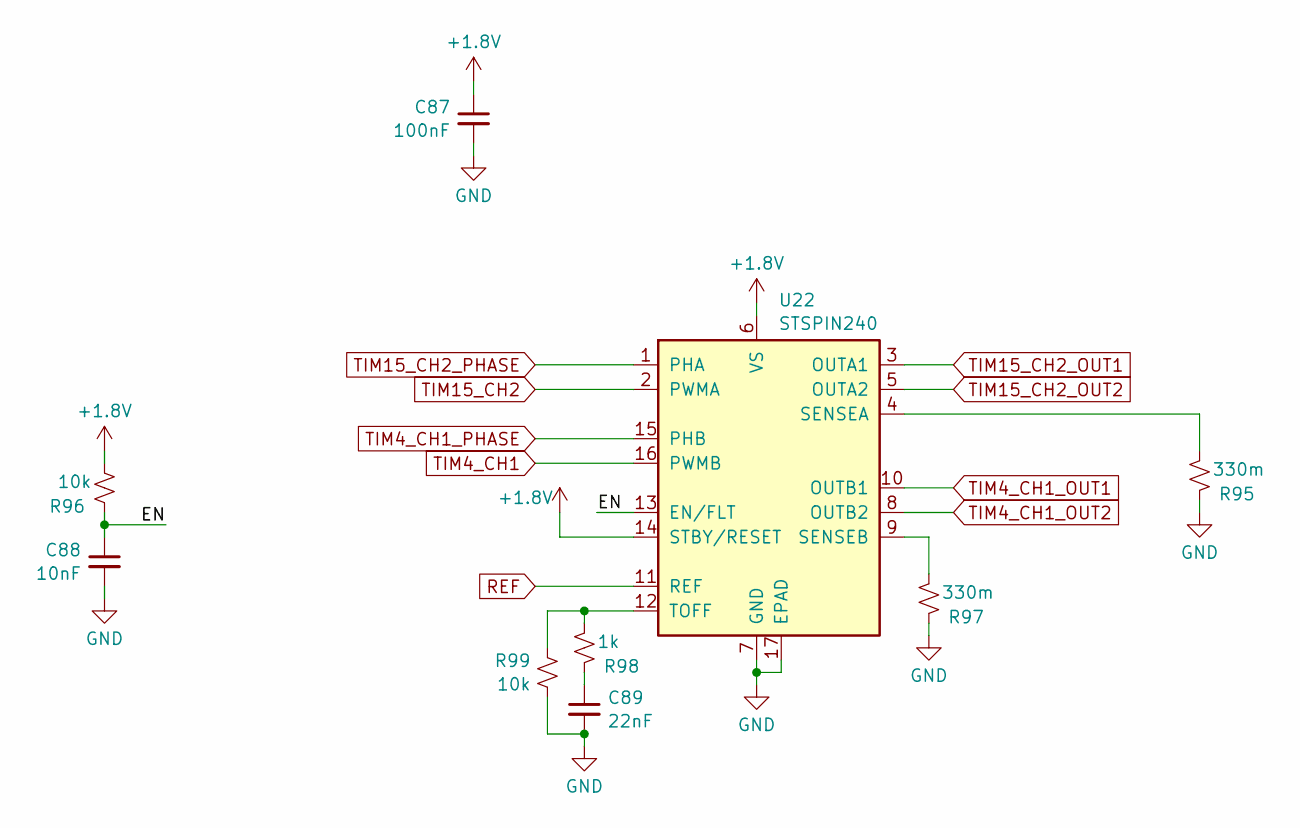
[picture p9: schematic TIM15_CH2_TIM4_CH1.kicad_sch]

Parts:
C87: 100nF; C_0402_1005Metric; LCSC C1525
C88: 10nF; C_0402_1005Metric; LCSC C15195
C89: 22nF; C_0402_1005Metric; LCSC C1532
R95, R97: 330m; R_0402_1005Metric; LCSC C332660
R96, R99: 10k; R_0402_1005Metric; LCSC C25744
R98: 1k; R_0402_1005Metric; LCSC C11702
U22: STSPIN240; VQFN-16-1EP_3x3mm_P0.5mm_EP1.8x1.8mm; LCSC C962258

Connections:
+1.8V: C87.1, R96.1, U22.6 (VS), U22.14 (STBY/RESET); also elsewhere on the board
/Actuators/TIM15_CH2_TIM4_CH1/EN: C88.1, R96.2, U22.13 (EN/FLT)
GND: C87.2, C88.2, C89.2, R95.2, R97.2, R99.2, U22.7 (GND), U22.17 (EPAD); also elsewhere on the board
unnamed: C89.1, R98.2
unnamed: R95.1, U22.4 (SENSEA)
unnamed: R97.1, U22.9 (SENSEB)
unnamed: R98.1, R99.1, U22.12 (TOFF)
REF: U22.11 (REF); also elsewhere on the board
TIM4_CH1: U22.16 (PWMB); also elsewhere on the board
TIM4_CH1_OUT1: U22.10 (OUTB1); also elsewhere on the board
TIM4_CH1_OUT2: U22.8 (OUTB2); also elsewhere on the board
TIM4_CH1_PHASE: U22.15 (PHB); also elsewhere on the board
TIM15_CH2: U22.2 (PWMA); also elsewhere on the board
TIM15_CH2_OUT1: U22.3 (OUTA1); also elsewhere on the board
TIM15_CH2_OUT2: U22.5 (OUTA2); also elsewhere on the board
TIM15_CH2_PHASE: U22.1 (PHA); also elsewhere on the board

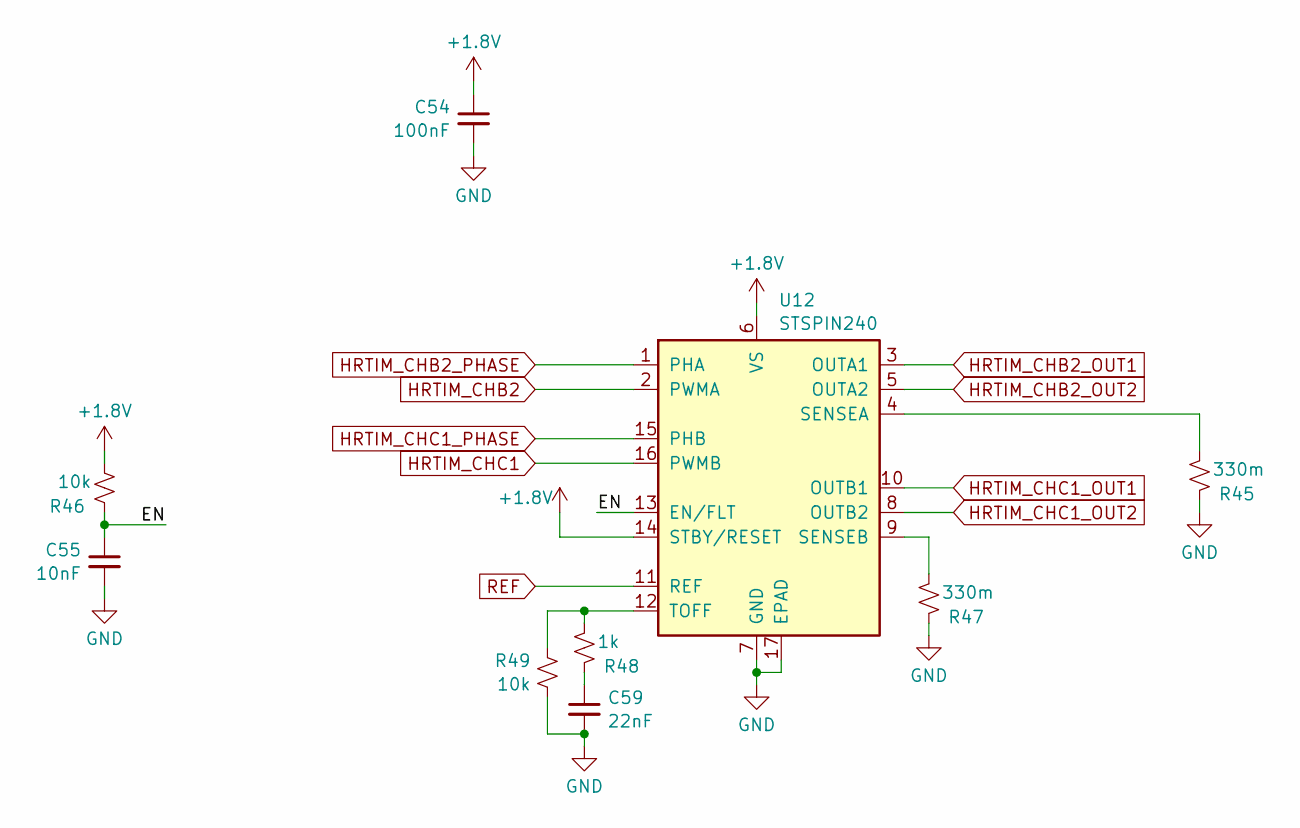
[picture p10: schematic HRTIM_CHB2_HRTIM_CHC1.kicad_sch]

Parts:
C54: 100nF; C_0402_1005Metric; LCSC C1525
C55: 10nF; C_0402_1005Metric; LCSC C15195
C59: 22nF; C_0402_1005Metric; LCSC C1532
R45, R47: 330m; R_0402_1005Metric; LCSC C332660
R46, R49: 10k; R_0402_1005Metric; LCSC C25744
R48: 1k; R_0402_1005Metric; LCSC C11702
U12: STSPIN240; VQFN-16-1EP_3x3mm_P0.5mm_EP1.8x1.8mm; LCSC C962258

Connections:
+1.8V: C54.1, R46.1, U12.6 (VS), U12.14 (STBY/RESET); also elsewhere on the board
/Actuators/HRTIM_CHB2_HRTIM_CHC1/EN: C55.1, R46.2, U12.13 (EN/FLT)
GND: C54.2, C55.2, C59.2, R45.2, R47.2, R49.2, U12.7 (GND), U12.17 (EPAD); also elsewhere on the board
HRTIM_CHB2: U12.2 (PWMA); also elsewhere on the board
HRTIM_CHB2_OUT1: U12.3 (OUTA1); also elsewhere on the board
HRTIM_CHB2_OUT2: U12.5 (OUTA2); also elsewhere on the board
HRTIM_CHB2_PHASE: U12.1 (PHA); also elsewhere on the board
HRTIM_CHC1: U12.16 (PWMB); also elsewhere on the board
HRTIM_CHC1_OUT1: U12.10 (OUTB1); also elsewhere on the board
HRTIM_CHC1_OUT2: U12.8 (OUTB2); also elsewhere on the board
HRTIM_CHC1_PHASE: U12.15 (PHB); also elsewhere on the board
unnamed: C59.1, R48.2
unnamed: R45.1, U12.4 (SENSEA)
unnamed: R47.1, U12.9 (SENSEB)
unnamed: R48.1, R49.1, U12.12 (TOFF)
REF: U12.11 (REF); also elsewhere on the board

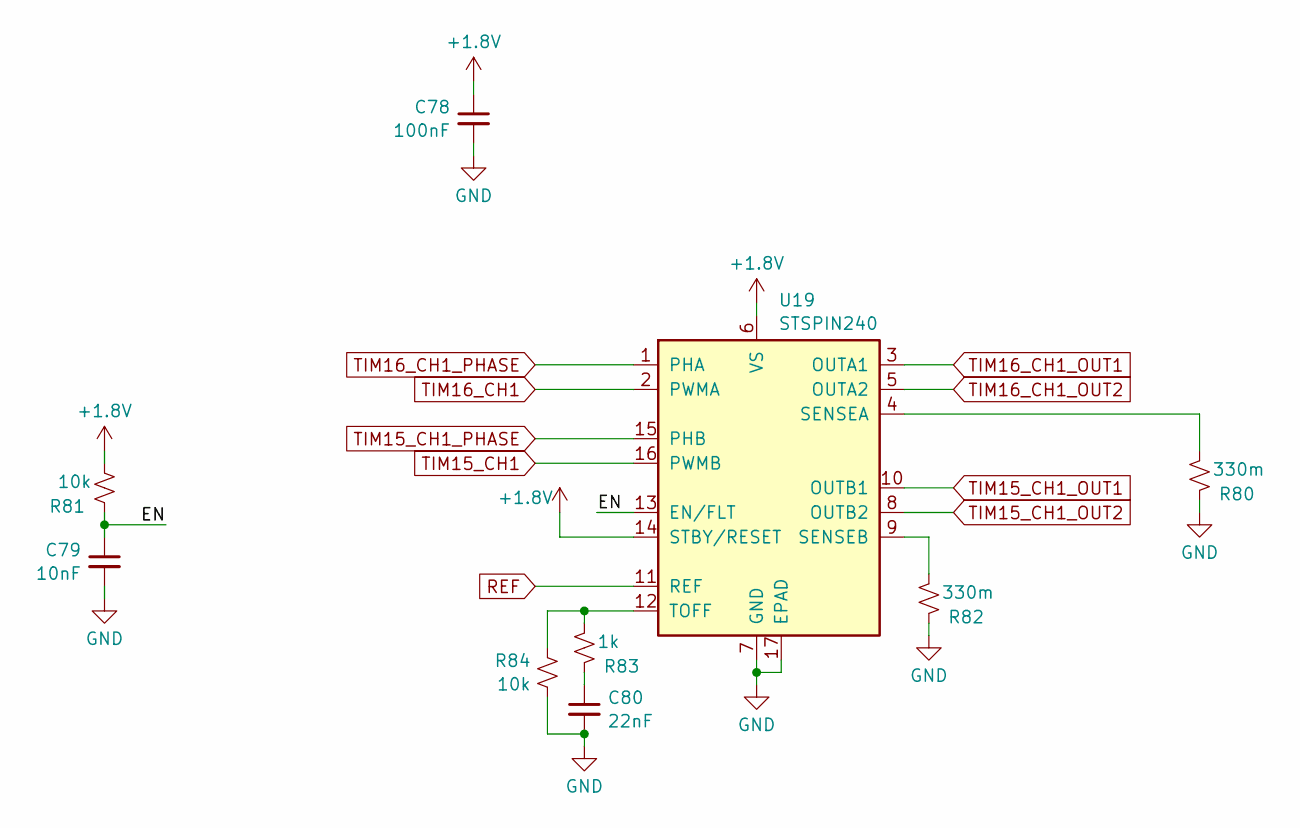
[picture p11: schematic TIM16_CH1_TIM15_CH1.kicad_sch]

Parts:
C78: 100nF; C_0402_1005Metric; LCSC C1525
C79: 10nF; C_0402_1005Metric; LCSC C15195
C80: 22nF; C_0402_1005Metric; LCSC C1532
R80, R82: 330m; R_0402_1005Metric; LCSC C332660
R81, R84: 10k; R_0402_1005Metric; LCSC C25744
R83: 1k; R_0402_1005Metric; LCSC C11702
U19: STSPIN240; VQFN-16-1EP_3x3mm_P0.5mm_EP1.8x1.8mm; LCSC C962258

Connections:
+1.8V: C78.1, R81.1, U19.6 (VS), U19.14 (STBY/RESET); also elsewhere on the board
/Actuators/TIM16_CH1_TIM15_CH1/EN: C79.1, R81.2, U19.13 (EN/FLT)
GND: C78.2, C79.2, C80.2, R80.2, R82.2, R84.2, U19.7 (GND), U19.17 (EPAD); also elsewhere on the board
unnamed: C80.1, R83.2
unnamed: R80.1, U19.4 (SENSEA)
unnamed: R82.1, U19.9 (SENSEB)
unnamed: R83.1, R84.1, U19.12 (TOFF)
REF: U19.11 (REF); also elsewhere on the board
TIM15_CH1: U19.16 (PWMB); also elsewhere on the board
TIM15_CH1_OUT1: U19.10 (OUTB1); also elsewhere on the board
TIM15_CH1_OUT2: U19.8 (OUTB2); also elsewhere on the board
TIM15_CH1_PHASE: U19.15 (PHB); also elsewhere on the board
TIM16_CH1: U19.2 (PWMA); also elsewhere on the board
TIM16_CH1_OUT1: U19.3 (OUTA1); also elsewhere on the board
TIM16_CH1_OUT2: U19.5 (OUTA2); also elsewhere on the board
TIM16_CH1_PHASE: U19.1 (PHA); also elsewhere on the board

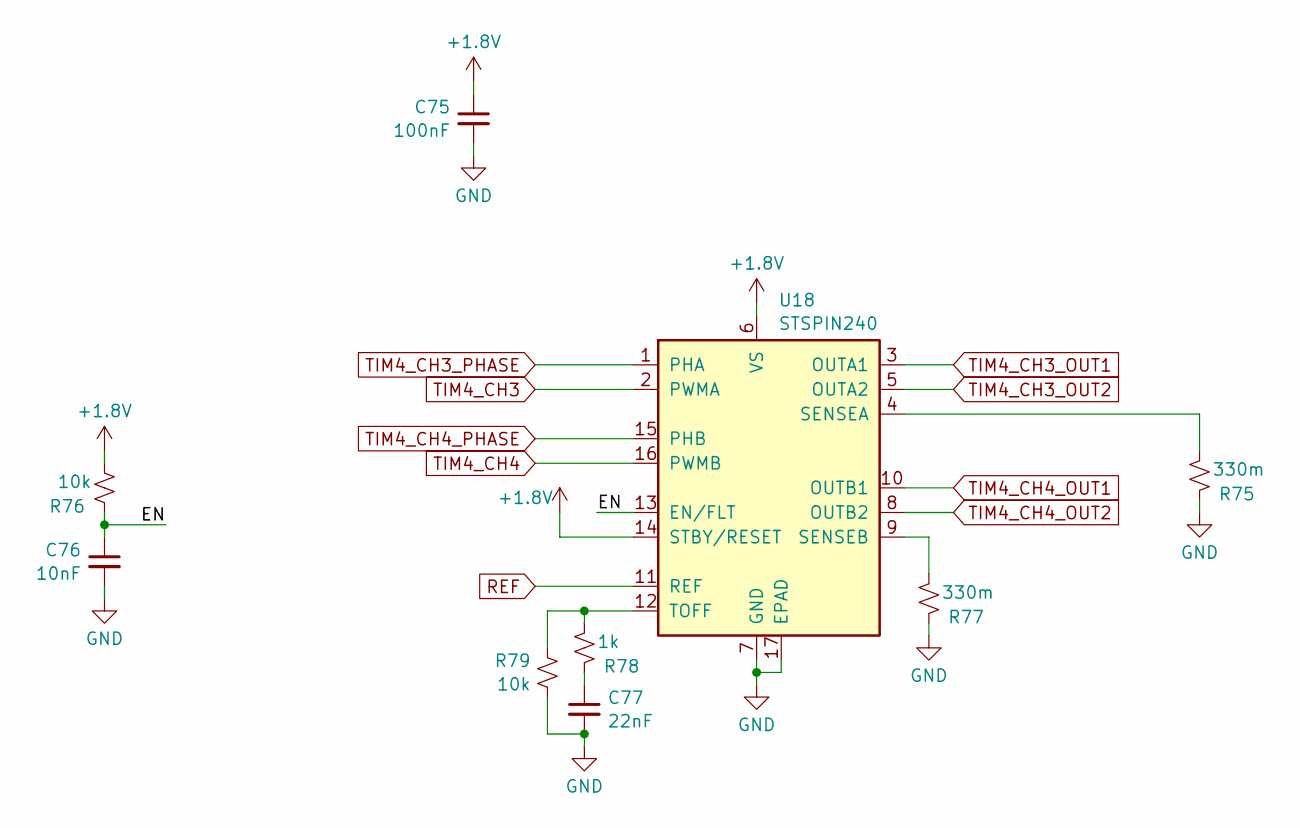
[picture p12: schematic TIM4_CH3_TIM4_CH4.kicad_sch]

Parts:
C75: 100nF; C_0402_1005Metric; LCSC C1525
C76: 10nF; C_0402_1005Metric; LCSC C15195
C77: 22nF; C_0402_1005Metric; LCSC C1532
R75, R77: 330m; R_0402_1005Metric; LCSC C332660
R76, R79: 10k; R_0402_1005Metric; LCSC C25744
R78: 1k; R_0402_1005Metric; LCSC C11702
U18: STSPIN240; VQFN-16-1EP_3x3mm_P0.5mm_EP1.8x1.8mm; LCSC C962258

Connections:
+1.8V: C75.1, R76.1, U18.6 (VS), U18.14 (STBY/RESET); also elsewhere on the board
/Actuators/TIM4_CH3_TIM4_CH4/EN: C76.1, R76.2, U18.13 (EN/FLT)
GND: C75.2, C76.2, C77.2, R75.2, R77.2, R79.2, U18.7 (GND), U18.17 (EPAD); also elsewhere on the board
unnamed: C77.1, R78.2
unnamed: R75.1, U18.4 (SENSEA)
unnamed: R77.1, U18.9 (SENSEB)
unnamed: R78.1, R79.1, U18.12 (TOFF)
REF: U18.11 (REF); also elsewhere on the board
TIM4_CH3: U18.2 (PWMA); also elsewhere on the board
TIM4_CH3_OUT1: U18.3 (OUTA1); also elsewhere on the board
TIM4_CH3_OUT2: U18.5 (OUTA2); also elsewhere on the board
TIM4_CH3_PHASE: U18.1 (PHA); also elsewhere on the board
TIM4_CH4: U18.16 (PWMB); also elsewhere on the board
TIM4_CH4_OUT1: U18.10 (OUTB1); also elsewhere on the board
TIM4_CH4_OUT2: U18.8 (OUTB2); also elsewhere on the board
TIM4_CH4_PHASE: U18.15 (PHB); also elsewhere on the board

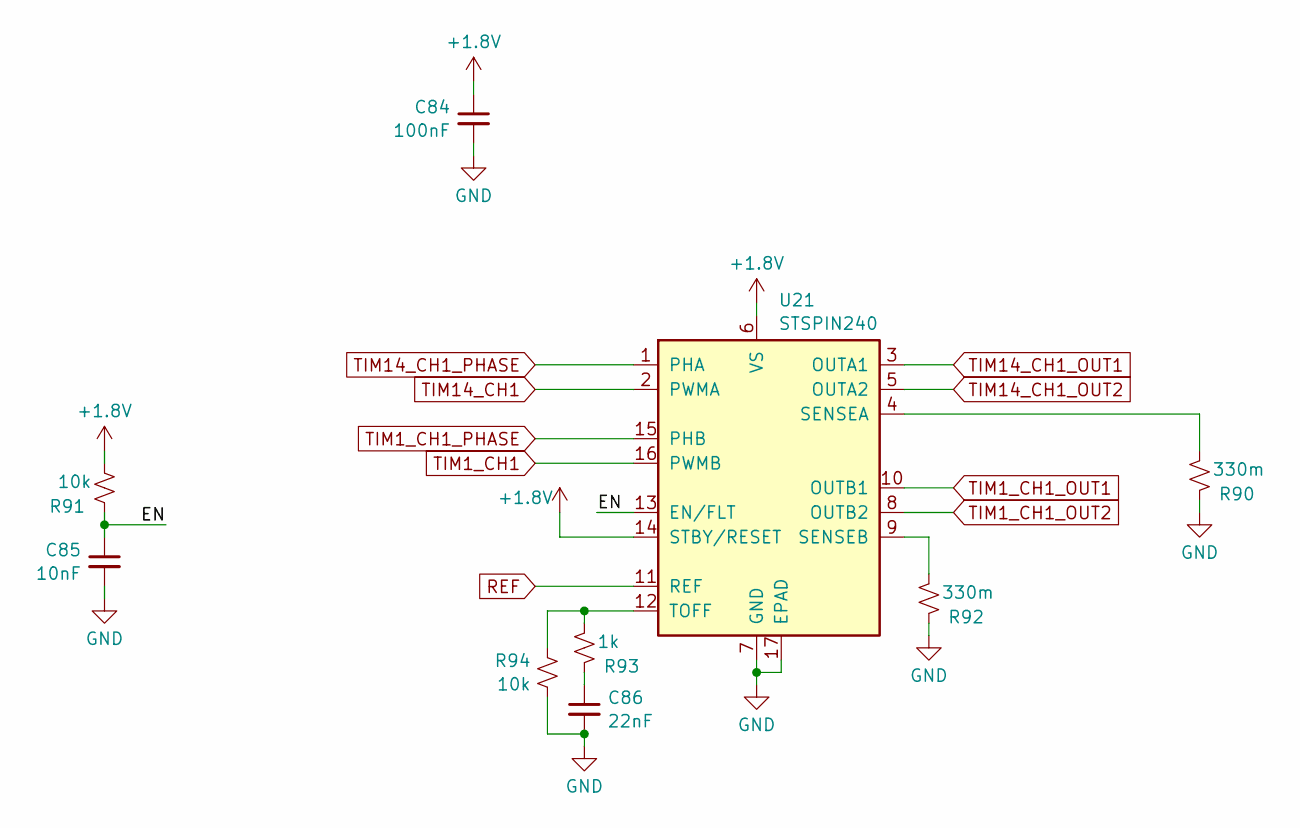
[picture p13: schematic TIM14_CH1_TIM1_CH1.kicad_sch]

Parts:
C84: 100nF; C_0402_1005Metric; LCSC C1525
C85: 10nF; C_0402_1005Metric; LCSC C15195
C86: 22nF; C_0402_1005Metric; LCSC C1532
R90, R92: 330m; R_0402_1005Metric; LCSC C332660
R91, R94: 10k; R_0402_1005Metric; LCSC C25744
R93: 1k; R_0402_1005Metric; LCSC C11702
U21: STSPIN240; VQFN-16-1EP_3x3mm_P0.5mm_EP1.8x1.8mm; LCSC C962258

Connections:
+1.8V: C84.1, R91.1, U21.6 (VS), U21.14 (STBY/RESET); also elsewhere on the board
/Actuators/TIM14_CH1_TIM1_CH1/EN: C85.1, R91.2, U21.13 (EN/FLT)
GND: C84.2, C85.2, C86.2, R90.2, R92.2, R94.2, U21.7 (GND), U21.17 (EPAD); also elsewhere on the board
unnamed: C86.1, R93.2
unnamed: R90.1, U21.4 (SENSEA)
unnamed: R92.1, U21.9 (SENSEB)
unnamed: R93.1, R94.1, U21.12 (TOFF)
REF: U21.11 (REF); also elsewhere on the board
TIM1_CH1: U21.16 (PWMB); also elsewhere on the board
TIM1_CH1_OUT1: U21.10 (OUTB1); also elsewhere on the board
TIM1_CH1_OUT2: U21.8 (OUTB2); also elsewhere on the board
TIM1_CH1_PHASE: U21.15 (PHB); also elsewhere on the board
TIM14_CH1: U21.2 (PWMA); also elsewhere on the board
TIM14_CH1_OUT1: U21.3 (OUTA1); also elsewhere on the board
TIM14_CH1_OUT2: U21.5 (OUTA2); also elsewhere on the board
TIM14_CH1_PHASE: U21.1 (PHA); also elsewhere on the board

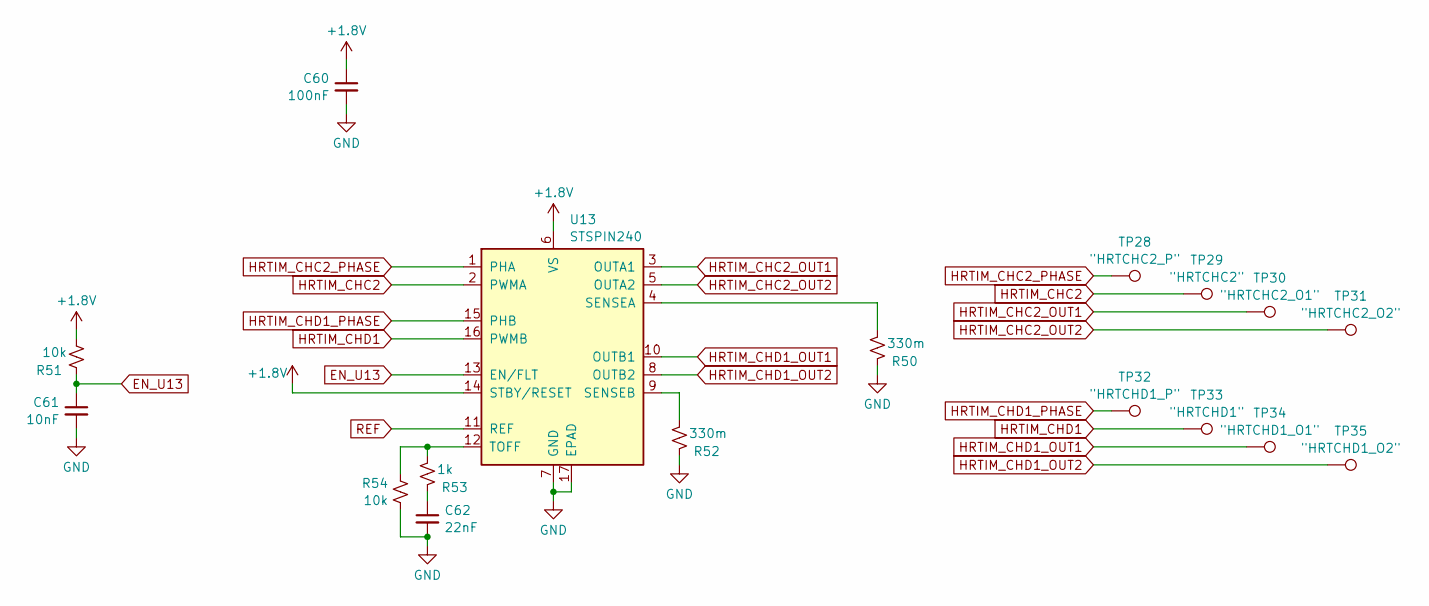
[picture p14: schematic HRTIM_CHC2_HRTIM_CHD1.kicad_sch]

Parts:
C60: 100nF; C_0402_1005Metric; LCSC C1525
C61: 10nF; C_0402_1005Metric; LCSC C15195
C62: 22nF; C_0402_1005Metric; LCSC C1532
R50, R52: 330m; R_0402_1005Metric; LCSC C332660
R51, R54: 10k; R_0402_1005Metric; LCSC C25744
R53: 1k; R_0402_1005Metric; LCSC C11702
TP28: "HRTCHC2_P"; TestPoint_Pad_1.0x1.0mm
TP29: "HRTCHC2"; TestPoint_Pad_1.0x1.0mm
TP30: "HRTCHC2_O1"; TestPoint_Pad_1.0x1.0mm
TP31: "HRTCHC2_O2"; TestPoint_Pad_1.0x1.0mm
TP32: "HRTCHD1_P"; TestPoint_Pad_1.0x1.0mm
TP33: "HRTCHD1"; TestPoint_Pad_1.0x1.0mm
TP34: "HRTCHD1_O1"; TestPoint_Pad_1.0x1.0mm
TP35: "HRTCHD1_O2"; TestPoint_Pad_1.0x1.0mm
U13: STSPIN240; VQFN-16-1EP_3x3mm_P0.5mm_EP1.8x1.8mm; LCSC C962258

Connections:
+1.8V: C60.1, R51.1, U13.6 (VS), U13.14 (STBY/RESET); also elsewhere on the board
EN_U13: C61.1, R51.2, U13.13 (EN/FLT); also elsewhere on the board
GND: C60.2, C61.2, C62.2, R50.2, R52.2, R54.2, U13.7 (GND), U13.17 (EPAD); also elsewhere on the board
HRTIM_CHC2: TP29.1, U13.2 (PWMA); also elsewhere on the board
HRTIM_CHC2_OUT1: TP30.1, U13.3 (OUTA1); also elsewhere on the board
HRTIM_CHC2_OUT2: TP31.1, U13.5 (OUTA2); also elsewhere on the board
HRTIM_CHC2_PHASE: TP28.1, U13.1 (PHA); also elsewhere on the board
HRTIM_CHD1: TP33.1, U13.16 (PWMB); also elsewhere on the board
HRTIM_CHD1_OUT1: TP34.1, U13.10 (OUTB1); also elsewhere on the board
HRTIM_CHD1_OUT2: TP35.1, U13.8 (OUTB2); also elsewhere on the board
HRTIM_CHD1_PHASE: TP32.1, U13.15 (PHB); also elsewhere on the board
unnamed: C62.1, R53.2
unnamed: R50.1, U13.4 (SENSEA)
unnamed: R52.1, U13.9 (SENSEB)
unnamed: R53.1, R54.1, U13.12 (TOFF)
REF: U13.11 (REF); also elsewhere on the board

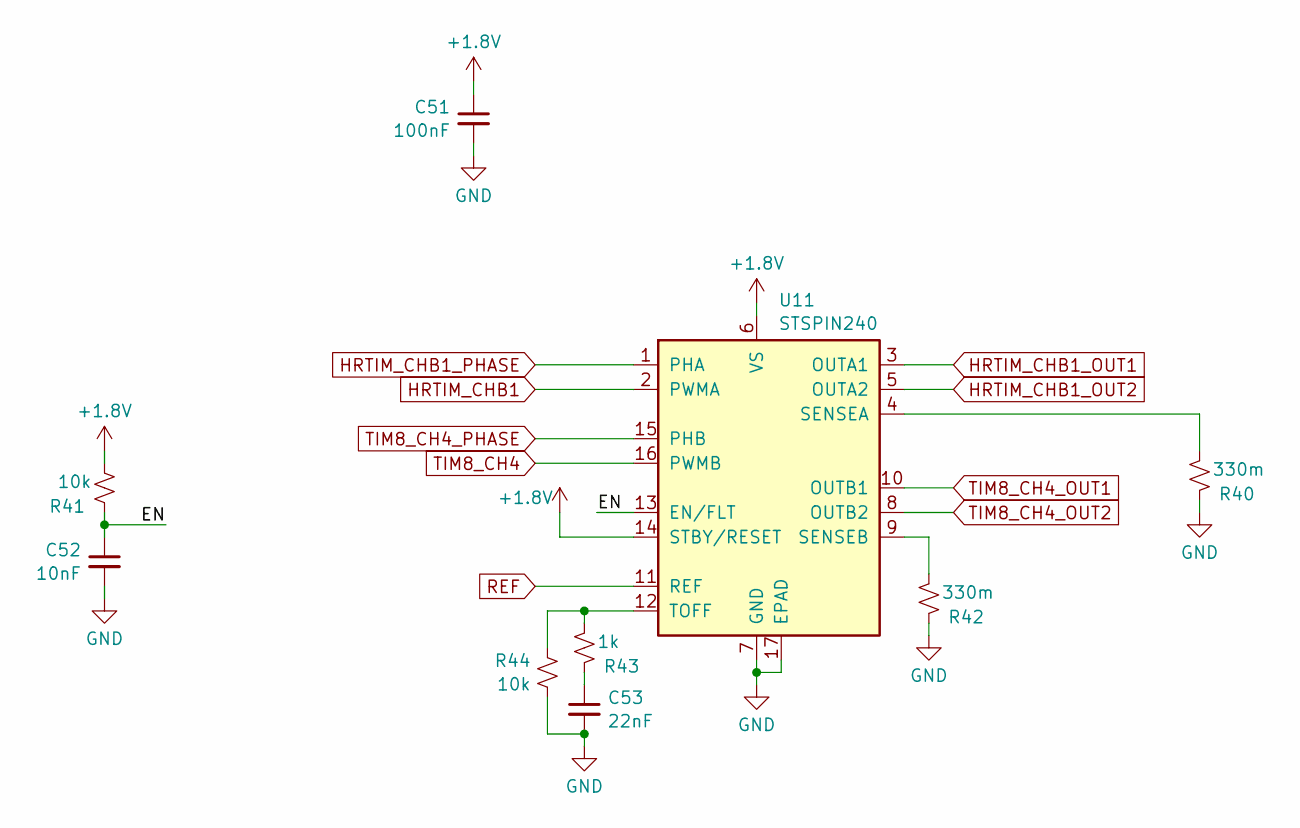
[picture p15: schematic HRTIM_CHB1_TIM8_CH4.kicad_sch]

Parts:
C51: 100nF; C_0402_1005Metric; LCSC C1525
C52: 10nF; C_0402_1005Metric; LCSC C15195
C53: 22nF; C_0402_1005Metric; LCSC C1532
R40, R42: 330m; R_0402_1005Metric; LCSC C332660
R41, R44: 10k; R_0402_1005Metric; LCSC C25744
R43: 1k; R_0402_1005Metric; LCSC C11702
U11: STSPIN240; VQFN-16-1EP_3x3mm_P0.5mm_EP1.8x1.8mm; LCSC C962258

Connections:
+1.8V: C51.1, R41.1, U11.6 (VS), U11.14 (STBY/RESET); also elsewhere on the board
/Actuators/HRTIM_CHB1_TIM8_CH4/EN: C52.1, R41.2, U11.13 (EN/FLT)
GND: C51.2, C52.2, C53.2, R40.2, R42.2, R44.2, U11.7 (GND), U11.17 (EPAD); also elsewhere on the board
HRTIM_CHB1: U11.2 (PWMA); also elsewhere on the board
HRTIM_CHB1_OUT1: U11.3 (OUTA1); also elsewhere on the board
HRTIM_CHB1_OUT2: U11.5 (OUTA2); also elsewhere on the board
HRTIM_CHB1_PHASE: U11.1 (PHA); also elsewhere on the board
unnamed: C53.1, R43.2
unnamed: R40.1, U11.4 (SENSEA)
unnamed: R42.1, U11.9 (SENSEB)
unnamed: R43.1, R44.1, U11.12 (TOFF)
REF: U11.11 (REF); also elsewhere on the board
TIM8_CH4: U11.16 (PWMB); also elsewhere on the board
TIM8_CH4_OUT1: U11.10 (OUTB1); also elsewhere on the board
TIM8_CH4_OUT2: U11.8 (OUTB2); also elsewhere on the board
TIM8_CH4_PHASE: U11.15 (PHB); also elsewhere on the board

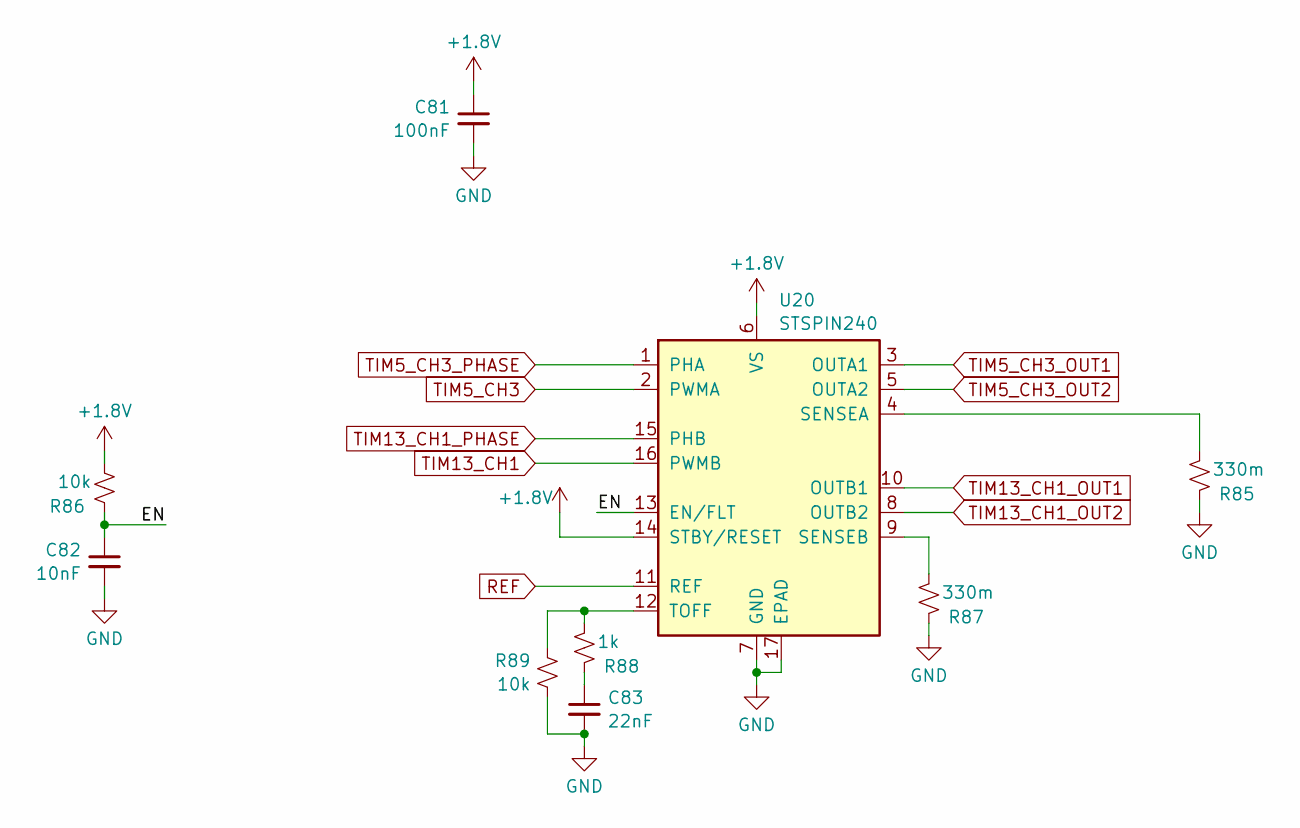
[picture p16: schematic TIM5_CH3_TIM13_CH1.kicad_sch]

Parts:
C81: 100nF; C_0402_1005Metric; LCSC C1525
C82: 10nF; C_0402_1005Metric; LCSC C15195
C83: 22nF; C_0402_1005Metric; LCSC C1532
R85, R87: 330m; R_0402_1005Metric; LCSC C332660
R86, R89: 10k; R_0402_1005Metric; LCSC C25744
R88: 1k; R_0402_1005Metric; LCSC C11702
U20: STSPIN240; VQFN-16-1EP_3x3mm_P0.5mm_EP1.8x1.8mm; LCSC C962258

Connections:
+1.8V: C81.1, R86.1, U20.6 (VS), U20.14 (STBY/RESET); also elsewhere on the board
/Actuators/TIM5_CH3_TIM13_CH1/EN: C82.1, R86.2, U20.13 (EN/FLT)
GND: C81.2, C82.2, C83.2, R85.2, R87.2, R89.2, U20.7 (GND), U20.17 (EPAD); also elsewhere on the board
unnamed: C83.1, R88.2
unnamed: R85.1, U20.4 (SENSEA)
unnamed: R87.1, U20.9 (SENSEB)
unnamed: R88.1, R89.1, U20.12 (TOFF)
REF: U20.11 (REF); also elsewhere on the board
TIM5_CH3: U20.2 (PWMA); also elsewhere on the board
TIM5_CH3_OUT1: U20.3 (OUTA1); also elsewhere on the board
TIM5_CH3_OUT2: U20.5 (OUTA2); also elsewhere on the board
TIM5_CH3_PHASE: U20.1 (PHA); also elsewhere on the board
TIM13_CH1: U20.16 (PWMB); also elsewhere on the board
TIM13_CH1_OUT1: U20.10 (OUTB1); also elsewhere on the board
TIM13_CH1_OUT2: U20.8 (OUTB2); also elsewhere on the board
TIM13_CH1_PHASE: U20.15 (PHB); also elsewhere on the board

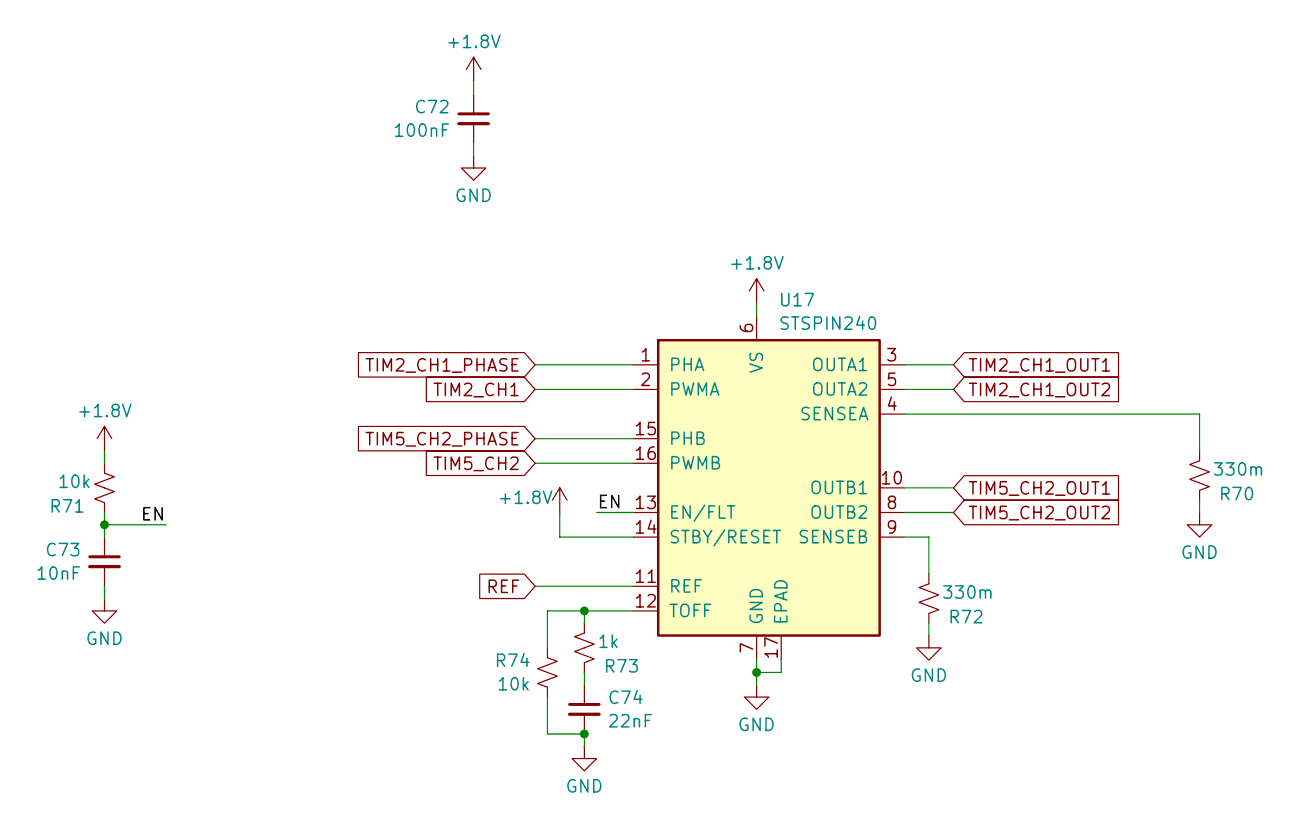
[picture p17: schematic TIM2_CH1_TIM5_CH2.kicad_sch]

Parts:
C72: 100nF; C_0402_1005Metric; LCSC C1525
C73: 10nF; C_0402_1005Metric; LCSC C15195
C74: 22nF; C_0402_1005Metric; LCSC C1532
R70, R72: 330m; R_0402_1005Metric; LCSC C332660
R71, R74: 10k; R_0402_1005Metric; LCSC C25744
R73: 1k; R_0402_1005Metric; LCSC C11702
U17: STSPIN240; VQFN-16-1EP_3x3mm_P0.5mm_EP1.8x1.8mm; LCSC C962258

Connections:
+1.8V: C72.1, R71.1, U17.6 (VS), U17.14 (STBY/RESET); also elsewhere on the board
/Actuators/TIM2_CH1_TIM5_CH2/EN: C73.1, R71.2, U17.13 (EN/FLT)
GND: C72.2, C73.2, C74.2, R70.2, R72.2, R74.2, U17.7 (GND), U17.17 (EPAD); also elsewhere on the board
unnamed: C74.1, R73.2
unnamed: R70.1, U17.4 (SENSEA)
unnamed: R72.1, U17.9 (SENSEB)
unnamed: R73.1, R74.1, U17.12 (TOFF)
REF: U17.11 (REF); also elsewhere on the board
TIM2_CH1: U17.2 (PWMA); also elsewhere on the board
TIM2_CH1_OUT1: U17.3 (OUTA1); also elsewhere on the board
TIM2_CH1_OUT2: U17.5 (OUTA2); also elsewhere on the board
TIM2_CH1_PHASE: U17.1 (PHA); also elsewhere on the board
TIM5_CH2: U17.16 (PWMB); also elsewhere on the board
TIM5_CH2_OUT1: U17.10 (OUTB1); also elsewhere on the board
TIM5_CH2_OUT2: U17.8 (OUTB2); also elsewhere on the board
TIM5_CH2_PHASE: U17.15 (PHB); also elsewhere on the board

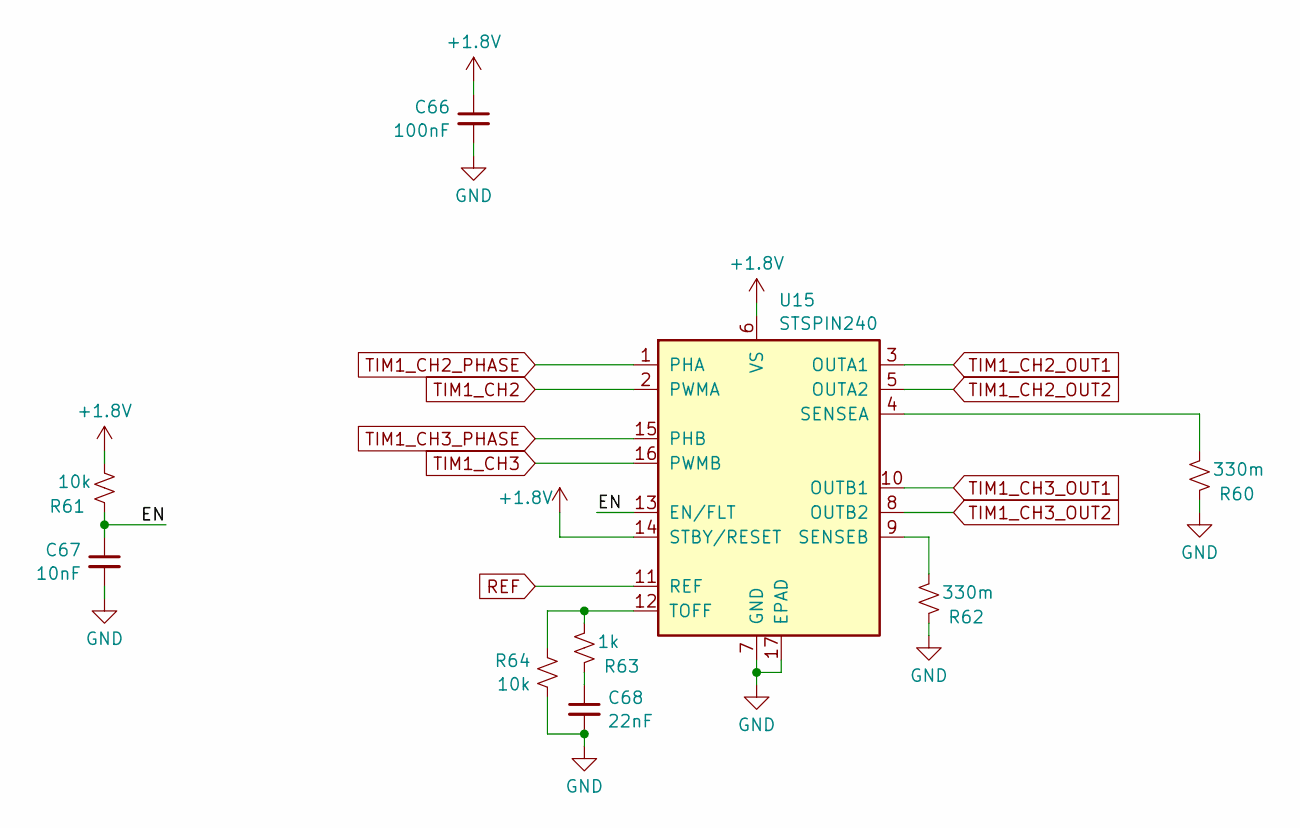
[picture p18: schematic TIM1_CH2_TIM1_CH3.kicad_sch]

Parts:
C66: 100nF; C_0402_1005Metric; LCSC C1525
C67: 10nF; C_0402_1005Metric; LCSC C15195
C68: 22nF; C_0402_1005Metric; LCSC C1532
R60, R62: 330m; R_0402_1005Metric; LCSC C332660
R61, R64: 10k; R_0402_1005Metric; LCSC C25744
R63: 1k; R_0402_1005Metric; LCSC C11702
U15: STSPIN240; VQFN-16-1EP_3x3mm_P0.5mm_EP1.8x1.8mm; LCSC C962258

Connections:
+1.8V: C66.1, R61.1, U15.6 (VS), U15.14 (STBY/RESET); also elsewhere on the board
/Actuators/TIM1_CH2_TIM1_CH3/EN: C67.1, R61.2, U15.13 (EN/FLT)
GND: C66.2, C67.2, C68.2, R60.2, R62.2, R64.2, U15.7 (GND), U15.17 (EPAD); also elsewhere on the board
unnamed: C68.1, R63.2
unnamed: R60.1, U15.4 (SENSEA)
unnamed: R62.1, U15.9 (SENSEB)
unnamed: R63.1, R64.1, U15.12 (TOFF)
REF: U15.11 (REF); also elsewhere on the board
TIM1_CH2: U15.2 (PWMA); also elsewhere on the board
TIM1_CH2_OUT1: U15.3 (OUTA1); also elsewhere on the board
TIM1_CH2_OUT2: U15.5 (OUTA2); also elsewhere on the board
TIM1_CH2_PHASE: U15.1 (PHA); also elsewhere on the board
TIM1_CH3: U15.16 (PWMB); also elsewhere on the board
TIM1_CH3_OUT1: U15.10 (OUTB1); also elsewhere on the board
TIM1_CH3_OUT2: U15.8 (OUTB2); also elsewhere on the board
TIM1_CH3_PHASE: U15.15 (PHB); also elsewhere on the board

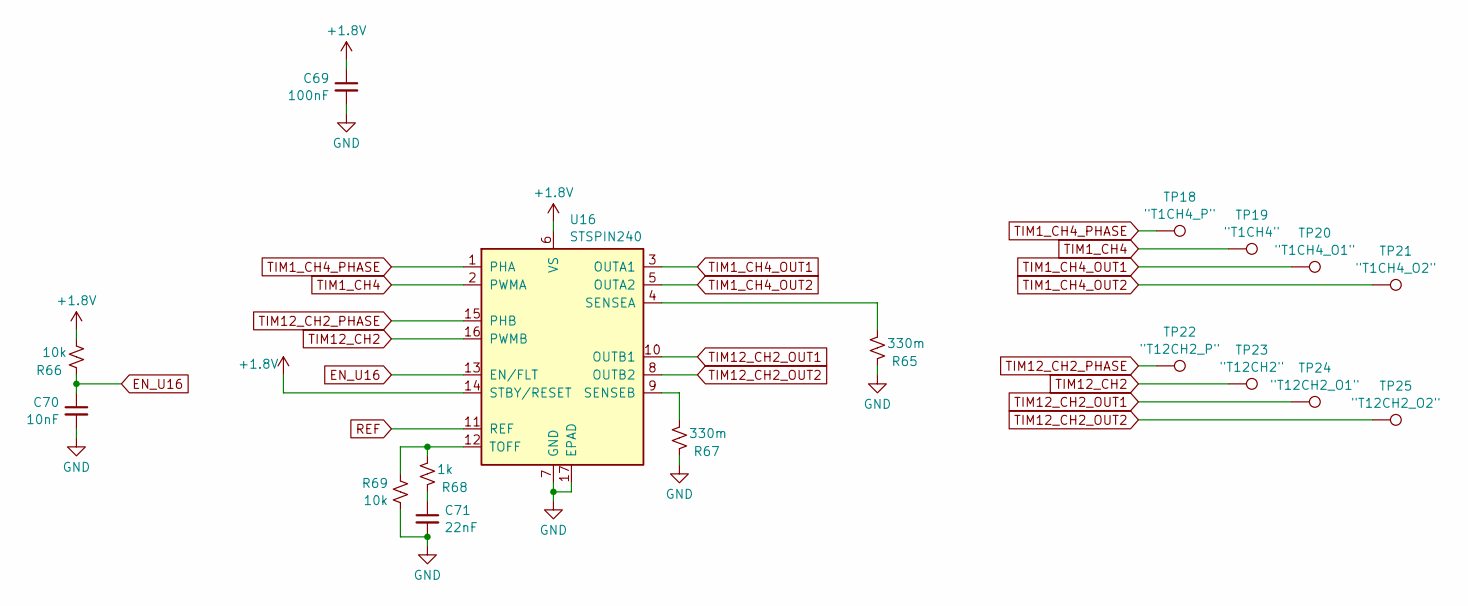
[picture p19: schematic TIM1_CH4_TIM12_CH2.kicad_sch]

Parts:
C69: 100nF; C_0402_1005Metric; LCSC C1525
C70: 10nF; C_0402_1005Metric; LCSC C15195
C71: 22nF; C_0402_1005Metric; LCSC C1532
R65, R67: 330m; R_0402_1005Metric; LCSC C332660
R66, R69: 10k; R_0402_1005Metric; LCSC C25744
R68: 1k; R_0402_1005Metric; LCSC C11702
TP18: "T1CH4_P"; TestPoint_Pad_1.0x1.0mm
TP19: "T1CH4"; TestPoint_Pad_1.0x1.0mm
TP20: "T1CH4_O1"; TestPoint_Pad_1.0x1.0mm
TP21: "T1CH4_O2"; TestPoint_Pad_1.0x1.0mm
TP22: "T12CH2_P"; TestPoint_Pad_1.0x1.0mm
TP23: "T12CH2"; TestPoint_Pad_1.0x1.0mm
TP24: "T12CH2_O1"; TestPoint_Pad_1.0x1.0mm
TP25: "T12CH2_O2"; TestPoint_Pad_1.0x1.0mm
U16: STSPIN240; VQFN-16-1EP_3x3mm_P0.5mm_EP1.8x1.8mm; LCSC C962258

Connections:
+1.8V: C69.1, R66.1, U16.6 (VS), U16.14 (STBY/RESET); also elsewhere on the board
EN_U16: C70.1, R66.2, U16.13 (EN/FLT); also elsewhere on the board
GND: C69.2, C70.2, C71.2, R65.2, R67.2, R69.2, U16.7 (GND), U16.17 (EPAD); also elsewhere on the board
unnamed: C71.1, R68.2
unnamed: R65.1, U16.4 (SENSEA)
unnamed: R67.1, U16.9 (SENSEB)
unnamed: R68.1, R69.1, U16.12 (TOFF)
REF: U16.11 (REF); also elsewhere on the board
TIM1_CH4: TP19.1, U16.2 (PWMA); also elsewhere on the board
TIM1_CH4_OUT1: TP20.1, U16.3 (OUTA1); also elsewhere on the board
TIM1_CH4_OUT2: TP21.1, U16.5 (OUTA2); also elsewhere on the board
TIM1_CH4_PHASE: TP18.1, U16.1 (PHA); also elsewhere on the board
TIM12_CH2: TP23.1, U16.16 (PWMB); also elsewhere on the board
TIM12_CH2_OUT1: TP24.1, U16.10 (OUTB1); also elsewhere on the board
TIM12_CH2_OUT2: TP25.1, U16.8 (OUTB2); also elsewhere on the board
TIM12_CH2_PHASE: TP22.1, U16.15 (PHB); also elsewhere on the board
