gabeak2/KASM_ACTUATOR_PCB_REV2/kasm_pcb_rev2.kicad_pcb

## KiCad design kasm_pcb_rev2.kicad_pcb (continued)

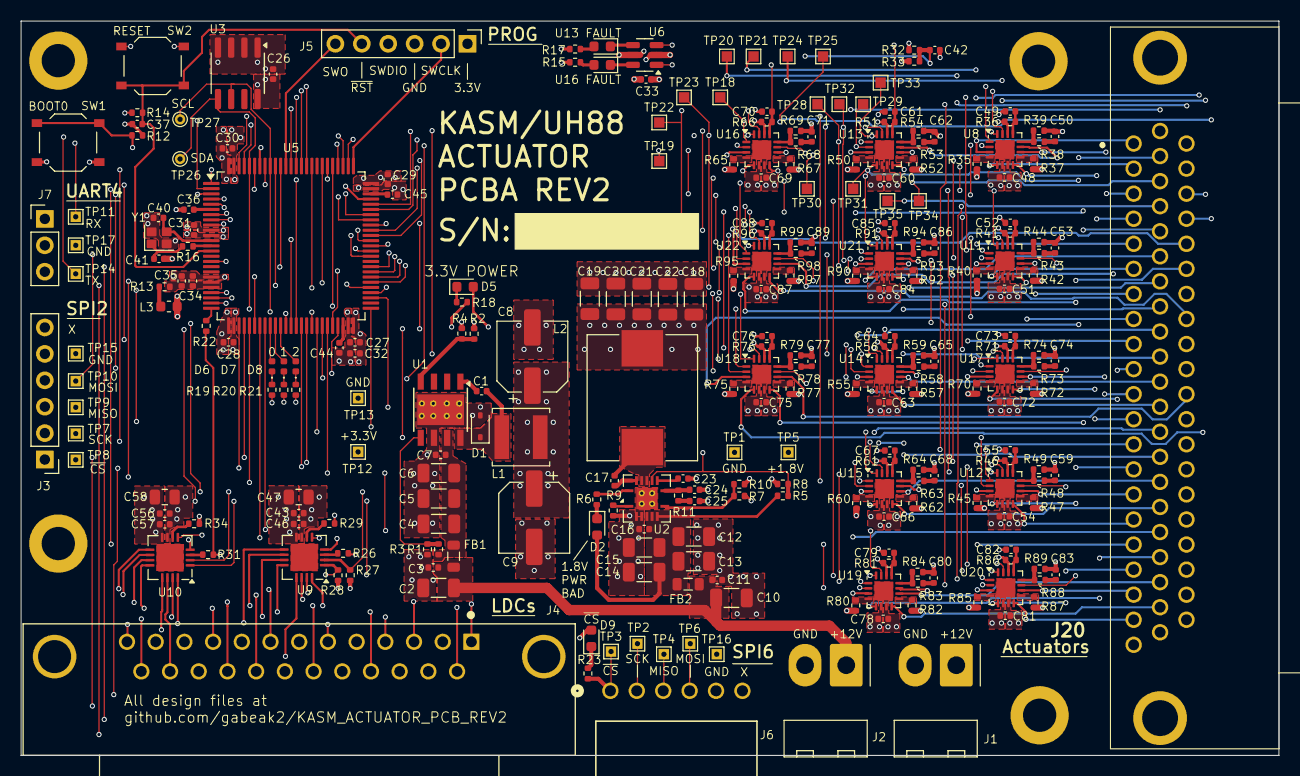
[picture p20: board kasm_pcb_rev2.kicad_pcb from above]

Board: 6 copper layers, 121.0 x 70.6 mm, 267 parts (0 on the bottom side), 251 nets.
